MahleCube/solar-circuit/hardware/c07/matlab/README.md

必要環境：MATLAB、Simulink、Simscape、Simscape Electrical、Simscape Battery。
