MahleCube/solar-circuit/hardware/c07/pcb-wip/LICENSES/NOTICES.md

# Third-party asset notices

These notices accompany the symbol, footprint, and 3D-model assets in this C07 project. Each asset retains its upstream terms. This directory does not assign a new license to the circuit or PCB design as a whole.

## KiCad library data

KiCad library data, including KiCad-derived portions of the local symbol and footprint libraries, is provided under Creative Commons Attribution-ShareAlike 4.0 with the KiCad electronic-design exception. The exception and KiCad's redistribution guidance are reproduced unmodified in [KiCad-Libraries-License.md](KiCad-Libraries-License.md). The complete license text is in [CC-BY-SA-4.0.txt](CC-BY-SA-4.0.txt). Attribution is to the KiCad library contributors and the authors identified in individual files.

The following STEP files contain an explicit CC-BY-SA 4.0 notice and design exception in their original headers.

- `3dmodels/C07_Reviewed_Power.3dshapes/MSOP-16-1EP_3x4.039mm_P0.5mm_EP1.651x2.845mm.step`
- `3dmodels/C07_Reviewed_Power.3dshapes/MSOP-16_3x4.039mm_P0.5mm.step`
- `3dmodels/C07_Reviewed_Power.3dshapes/TO-263-2.step`
- `3dmodels/C07_Reviewed_Special.3dshapes/Nexperia_SOT363_3.step`
- `3dmodels/stock/Package_TO_SOT_SMD.3dshapes/TSOT-23-8.step`

The local KiCad-derived assets include project adaptations to geometry, pad dimensions, model associations, or package naming. Original attribution and license headers are retained.

## Legacy KiCad StepUp model

`3dmodels/C07_Reviewed_Special.3dshapes/Nexperia_SOD123F.step` retains its original `D_SOD-123F.step` header, copyright 2017 kicad StepUp, and GNU GPL version 3 or later with the embedded design-use exception. The full GPL version 3 text is in [GPL-3.0.txt](GPL-3.0.txt). The exact exception and risk disclaimer remain in the model header.

## Manufacturer and project models

Manufacturer-provided assets retain their embedded authorship information and applicable upstream terms. The Vishay notice is included at `3dmodels/manufacturer/99917_read_me_3D_disclaimer.pdf`. It describes the model as supplied as-is and does not provide a separate redistribution license.

Project-generated reference models and assembly envelopes are identified by their existing project records and file metadata. A manufacturer's name or part number in a filename identifies the represented part and does not by itself establish that the manufacturer supplied the model.

## Sources of the unmodified license documents

- CC-BY-SA 4.0 legal text — https://creativecommons.org/licenses/by-sa/4.0/legalcode.txt
- KiCad Libraries License and design exception — https://gitlab.com/kicad/libraries/kicad-symbols/-/raw/master/LICENSE.md
- KiCad library licensing guidance — https://www.kicad.org/libraries/license/
- GPL version 3 legal text — https://raw.githubusercontent.com/coreutils/coreutils/master/COPYING, as distributed by the GNU Coreutils project
- GPL version 3 canonical reference — https://www.gnu.org/licenses/gpl-3.0.html
