MahleCube/solar-circuit/hardware/c07/matlab/c07_preview.png

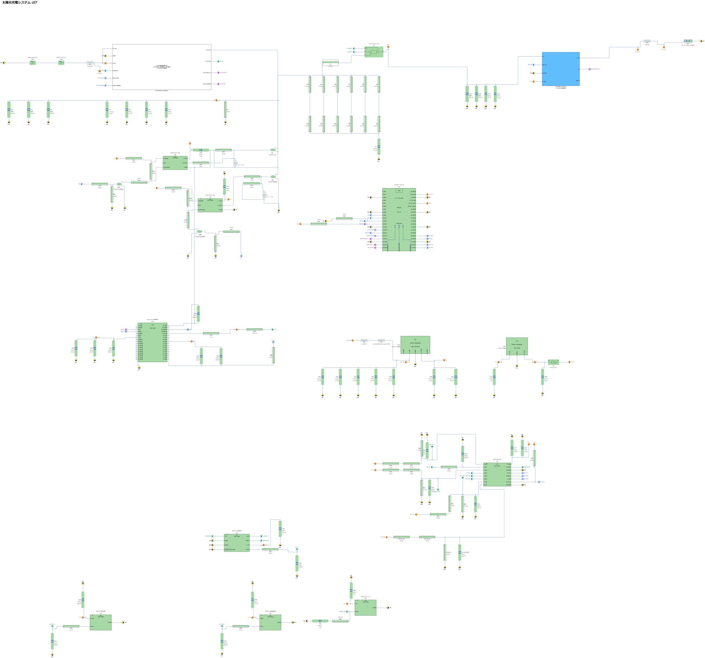
hardware/c07/matlab/c07_preview.png
