MahleCube/solar-circuit/docs/bom/c07_BOM.xlsx

Sheet: 部品集計
太陽光充電システム c07 BOM
1台分の図面BOM 2026-10-29作成 数量は購入パッケージ単位
総数量 | 188 | 集計行数 | 112 | 未選定 | 32 | 候補 | 6
パネル2枚・蓄電池1台を含む。Q3A・Q3BはデュアルMOSFET 1個として計上。
型番未選定・候補は状態欄で確認。基板、配線、端子台、ヒューズホルダー、放熱器、固定具は別途。
集計No | 部品種別 | メーカー型番 | 公称値・仕様 | 数量（個） | 部品番号 | 型番の状態 | 補足
BOM-001 | MOSFET | IPB048N15N5LFATMA1 | 150 V・4.8 mΩ（25℃・VGS=10 V） | 4 | PV_Q1, PV_Q2, P_Q1, P_Q2 | 候補含む | 図面で使用する候補。購入品としての確定・成立確認は未完了。
BOM-002 | MOSFET | PMGD175XNEX | デュアルNチャネル・30 V | 1 | Q3A / Q3B | 型番記載 | デュアルMOSFET。Q3A・Q3Bの2素子を購入数量1個として計上。
BOM-003 | MOSFET | TK9R6E15Q5,S1X | NチャネルMOSFET | 2 | Q1, Q2 | 型番記載
BOM-004 | IC | ACPL-P346-560E | フォトカプラ内蔵ゲートドライバ | 2 | U8, U9 | 型番記載
BOM-005 | IC | INA241A3IDDFR | 電流検出アンプ・50 V/V | 2 | U2, U3 | 型番記載
BOM-006 | IC | LTC4364IMS-1#PBF | LTC4364-1・MSOP-16 | 1 | P_U1 | 型番記載
BOM-007 | IC | LTC7000ARMSE#PBF | LTC7000A・高側ゲート駆動 | 1 | PV_U1 | 型番記載
BOM-008 | IC | MCP3208-CI/SL | 12 bit・8チャネル | 1 | U1 | 型番記載
BOM-009 | IC | REF3025EAIDBZR | REF3025EAIDBZR / 2.5V | 1 | U6 | 型番記載
BOM-010 | IC | SN74LVC1G11DBVR | 3入力ANDゲート | 1 | PV_U4 | 型番記載
BOM-011 | IC | SN74LVC1G74DCTR | Dフリップフロップ | 1 | PV_U5 | 型番記載
BOM-012 | IC | TLV3201AIDBVR | 高速コンパレータ | 1 | PV_U3 | 型番記載
BOM-013 | IC | TMP235A2DBZR | アナログ温度センサー | 2 | U4, U5 | 型番記載
BOM-014 | IC | TPS37042BJOFDDFRQ1 | 2系統電圧監視 | 1 | PV_U6 | 型番記載
BOM-015 | マイコンボード | SC0918 | Raspberry Pi Pico W (SC0918) | 1 | U7 | 型番記載
BOM-016 | 電源IC・モジュール | TSR 1-2450 | 12 V入力→5 V・1 A | 1 | U12 | 型番記載
BOM-017 | 電源IC・モジュール | TSR 1-48120WI | 電池入力→12 V・1 A | 1 | U11 | 型番記載
BOM-018 | 電源IC・モジュール | UCC14131QDWNRQ1 | 絶縁型・浮動約12 V出力 | 1 | U10 | 型番記載
BOM-019 | ダイオード | BZT52H-C15,115 | 15 V・ゲートクランプ | 3 | D1, D2, PV_D_GS | 型番記載
BOM-020 | ダイオード | CMZ5945B TR13 PBFREE | 68 V | 1 | P_D1 | 型番記載
BOM-021 | ダイオード | DDZ9702T | 15 V | 2 | P_D6, P_D7 | 型番記載
BOM-022 | ダイオード | MMBD1501A | 仕様は型番・図面説明を参照 | 1 | PV_D_BOOT | 型番候補 | 図面で使用する候補。購入品としての確定・成立確認は未完了。
BOM-023 | ダイオード | SS14-E3/61T | 40 V・1 A・ショットキー | 1 | D3 | 型番記載
BOM-024 | ダイオード | V20PW22-M3/I | 仕様は型番・図面説明を参照 | 3 | PV_D_FLY, PV_D_NEG, PV_D_TS | 型番候補 | 図面で使用する候補。購入品としての確定・成立確認は未完了。
BOM-025 | インダクタ | 74437636356203 | 62 µH | 1 | L2 | 型番記載
BOM-026 | インダクタ | NAC-20-0201 | 200 µH | 1 | L1 | 型番記載
BOM-027 | シャント抵抗 | CSS4J-4026R-1L00F | 1 mΩ・4端子 | 2 | R2, R27 | 型番記載
BOM-028 | シャント抵抗 | WSL36372L700FEA | 2.7 mΩ | 1 | P_RSNS | 型番記載
BOM-029 | 抵抗 | CRCW08051K00FKEA | 1 kΩ | 1 | P_RSHDN_SER | 型番記載
BOM-030 | 抵抗 | CRCW25124R42FKEGHP | 4.42 Ω | 12 | R3, R4, R5, R6, R7, R8, R9, R10, R11, R12, R13, R14 | 型番記載
BOM-031 | 抵抗 | CRCW25126K80FKEG | 6.8 kΩ | 1 | P_R4 | 型番記載
BOM-032 | 抵抗 | CRCW080510R0FKEA | 10 Ω | 1 | P_R5 | 型番記載
BOM-033 | 抵抗 | CRCW080522K0FKEA | 22 kΩ | 1 | P_RFLT_PU | 型番記載
BOM-034 | 抵抗 | CRCW080547K0FKEA | 47 kΩ | 1 | P_RSHDN_PD | 型番記載
BOM-035 | 抵抗 | ERJ3RSFR10V | 0.1 Ω 1% | 1 | R30 | 型番記載
BOM-036 | 抵抗 | ERJ6ENF10R0V | 10 Ω 1% 0.125W | 2 | R36, R43 | 型番記載
BOM-037 | 抵抗 | ERJ6ENF1002V | 10k 1% | 7 | R35, R37, R42, R44, R46, R48, R49 | 型番記載
BOM-038 | 抵抗 | ERJ6ENF1540V | 154 Ω 1% 0.125W | 2 | R32, R39 | 型番記載
BOM-039 | 抵抗 | ERJ6ENF2002V | 20k 1% | 2 | R33, R40 | 型番記載
BOM-040 | 抵抗 | ERJ6ENF2320V | 232 Ω 1% 0.125W | 2 | R31, R38 | 型番記載
BOM-041 | 抵抗 | ERJ6ENF3300V | 330 Ω 1% | 2 | R34, R41 | 型番記載
BOM-042 | 抵抗 | ERJ6ENF3832V | 38.3k 1% | 1 | R45 | 型番記載
BOM-043 | 抵抗 | ERJ6GEY0R00V | 0 Ω | 1 | R47 | 型番記載
BOM-044 | 抵抗 | PR02000201502FA100 | 15 kΩ | 1 | R1 | 型番記載
BOM-045 | 抵抗 | RC0603FR-0710KL | 10 kΩ | 1 | R15 | 型番記載
BOM-046 | 抵抗 | RG2012P-101-B-T5 | 100 Ω 0.1% | 2 | R25, R26 | 型番記載
BOM-047 | 抵抗 | RG2012P-332-B-T5 | 3.3 kΩ / 3.3 kΩ 0.1% | 4 | PV_RV_L, R18, R21, R24 | 型番記載
BOM-048 | 抵抗 | RG2012P-470-B-T5 | 47 Ω | 2 | R28, R29 | 型番記載
BOM-049 | 抵抗 | RG2012P-753-B-T5 | 75 kΩ / 75 kΩ 0.1% | 8 | PV_RV_H1, PV_RV_H2, R16, R17, R19, R20, R22, R23 | 型番記載
BOM-050 | 抵抗 | TNPW08052K74BEEA | 2.74 kΩ | 1 | P_R2 | 型番記載
BOM-051 | 抵抗 | TNPW08054K99BEEA | 4.99 kΩ | 2 | P_R3, P_R8 | 型番記載
BOM-052 | 抵抗 | TNPW0805236KBEEA | 236 kΩ | 1 | P_R7 | 型番記載
BOM-053 | 抵抗 | TNPW0805243KBEEA | 243 kΩ | 1 | P_R1 | 型番記載
BOM-054 | 抵抗 | 未選定 | 100 kΩ | 1 | PV_RAN | 型番未選定 | 公称値は図面の設定値。型番・定格・実装サイズは要選定。
BOM-055 | 抵抗 | 未選定 | 100 Ω | 1 | PV_RFLT | 型番未選定 | 公称値は図面の設定値。型番・定格・実装サイズは要選定。
BOM-056 | 抵抗 | 未選定 | 22 kΩ | 1 | PV_RFLT_PU | 型番未選定 | 公称値は図面の設定値。型番・定格・実装サイズは要選定。
BOM-057 | 抵抗 | 未選定 | 100 kΩ | 1 | PV_RG | 型番未選定 | 公称値は図面の設定値。型番・定格・実装サイズは要選定。
BOM-058 | 抵抗 | 未選定 | 10 MΩ | 1 | PV_RGS | 型番未選定 | 公称値は図面の設定値。型番・定格・実装サイズは要選定。
BOM-059 | 抵抗 | 未選定 | 100 kΩ | 1 | PV_RINP | 型番未選定 | 公称値は図面の設定値。型番・定格・実装サイズは要選定。
BOM-060 | 抵抗 | 未選定 | 820 kΩ | 1 | PV_ROV_H | 型番未選定 | 公称値は図面の設定値。型番・定格・実装サイズは要選定。
BOM-061 | 抵抗 | 未選定 | 10 kΩ | 1 | PV_ROV_L | 型番未選定 | 公称値は図面の設定値。型番・定格・実装サイズは要選定。
BOM-062 | 抵抗 | 未選定 | 100 kΩ | 1 | PV_RREARM | 型番未選定 | 公称値は図面の設定値。型番・定格・実装サイズは要選定。
BOM-063 | 抵抗 | 未選定 | 10.2 kΩ 0.1% | 1 | PV_RREV_H | 型番未選定 | 公称値は図面の設定値。型番・定格・実装サイズは要選定。
BOM-064 | 抵抗 | 未選定 | 9.8 kΩ 0.1% | 1 | PV_RREV_L | 型番未選定 | 公称値は図面の設定値。型番・定格・実装サイズは要選定。
BOM-065 | 抵抗 | 未選定 | 100 kΩ | 1 | PV_RRUN | 型番未選定 | 公称値は図面の設定値。型番・定格・実装サイズは要選定。
BOM-066 | 抵抗 | 未選定 | 100 kΩ | 1 | PV_RTIME | 型番未選定 | 公称値は図面の設定値。型番・定格・実装サイズは要選定。
BOM-067 | 抵抗 | 未選定 | 330 kΩ | 1 | PV_RUV_H | 型番未選定 | 公称値は図面の設定値。型番・定格・実装サイズは要選定。
BOM-068 | 抵抗 | 未選定 | 10.2 kΩ | 1 | PV_RUV_L | 型番未選定 | 公称値は図面の設定値。型番・定格・実装サイズは要選定。
BOM-069 | 抵抗 | 未選定 | 113 kΩ | 1 | PV_RVCCUV | 型番未選定 | 公称値は図面の設定値。型番・定格・実装サイズは要選定。
BOM-070 | 抵抗 | 未選定 | 10 Ω | 1 | PV_R_SLEW | 型番未選定 | 公称値は図面の設定値。型番・定格・実装サイズは要選定。
BOM-071 | 抵抗 | 未選定 | 21.3 kΩ | 1 | PV_R_SUP25 | 型番未選定 | 公称値は図面の設定値。型番・定格・実装サイズは要選定。
BOM-072 | 抵抗 | 未選定 | 10 kΩ | 1 | PV_R_SUP26 | 型番未選定 | 公称値は図面の設定値。型番・定格・実装サイズは要選定。
BOM-073 | 抵抗 | 未選定 | 31.2 kΩ | 1 | PV_R_SUP31 | 型番未選定 | 公称値は図面の設定値。型番・定格・実装サイズは要選定。
BOM-074 | 抵抗 | 未選定 | 10 kΩ | 1 | PV_R_SUP32 | 型番未選定 | 公称値は図面の設定値。型番・定格・実装サイズは要選定。
BOM-075 | 抵抗 | 未選定 | 10 kΩ | 1 | PV_R_SUP_PU | 型番未選定 | 公称値は図面の設定値。型番・定格・実装サイズは要選定。
BOM-076 | 積層セラミックC | AC0603JPNPO9BN681 | 680 pF | 2 | C27, C29 | 型番記載
BOM-077 | 積層セラミックC | C0805C104K4RACTU | 100 nF | 1 | C17 | 型番記載
BOM-078 | 積層セラミックC | C0805C331J5GACTU | 330pF 50V C0G 5% | 1 | C39 | 型番記載
BOM-079 | 積層セラミックC | C1210X225K1RACAUTO | 2.2µF 100V X7R | 5 | C40, C41, C42, C43, C44 | 型番記載
BOM-080 | 積層セラミックC | C1608X7R1H104K080AA | 100nF 50V | 2 | C22, C24 | 型番記載
BOM-081 | 積層セラミックC | C2012X7R1H105K125AB | 1 µF | 2 | C30, C31 | 型番記載
BOM-082 | 積層セラミックC | C3225C0G2J223J230AA | 22 nF | 1 | C1 | 型番記載
BOM-083 | 積層セラミックC | C3225X7R2A225K230AB | 2.2 µF | 1 | C18 | 型番記載
BOM-084 | 積層セラミックC | C5750X7T2E225K250KE | 2.2 µF | 3 | C8, C9, C10 | 型番記載
BOM-085 | 積層セラミックC | CC0603KRX7R9BB104 | 100 nF | 8 | C19, C20, C21, C23, C25, C26, C28, PV_CV_ADC | 型番記載
BOM-086 | 積層セラミックC | GRM21BR71H104KA01L | 100nF 50V X7R | 2 | C36, C38 | 型番記載
BOM-087 | 積層セラミックC | GRM21BR71H105KA12L | 1µF 50V X7R | 3 | C32, C33, C47 | 型番記載
BOM-088 | 積層セラミックC | GRM32EC72A106KE05L | 10 µF | 2 | C15, C16 | 型番記載
BOM-089 | 積層セラミックC | GRM32ER71E226KE15L | 22µF 25V X7R | 5 | C34, C35, C37, C45, C48 | 型番記載
BOM-090 | 電解コンデンサ | 100ZLH470MEFC16X31.5 | 470 µF | 2 | C13, C14 | 型番記載
BOM-091 | 電解コンデンサ | EEHZK1E471P | 470µF 25V hybrid | 1 | C46 | 型番記載
BOM-092 | 電解コンデンサ | UCY2C471MHD | 470 µF | 3 | C2, C3, C4 | 型番記載
BOM-093 | フィルムコンデンサ | R76IR433050H3J | 3.3 µF | 1 | C7 | 型番記載
BOM-094 | コンデンサ | 100ZLH330MEFC12.5X35 | 330 µF | 1 | P_COUT | 型番記載
BOM-095 | コンデンサ | CGA5L2C0G1H104J160AE | 100 nF | 1 | P_CTMR | 型番記載
BOM-096 | コンデンサ | CGA6P3C0G2E473J250AA | 47 nF | 1 | P_CHG | 型番記載
BOM-097 | コンデンサ | 未選定 | 10 µF | 1 | PV_CBST | 型番未選定 | 公称値は図面の設定値。型番・定格・実装サイズは要選定。 25 V級は図面説明上の候補。
BOM-098 | コンデンサ | 未選定 | 10 nF / 16 V | 1 | PV_CREV | 型番未選定 | 公称値は図面の設定値。型番・定格・実装サイズは要選定。
BOM-099 | コンデンサ | 未選定 | 1 nF / 25 V | 1 | PV_CTIME | 型番未選定 | 公称値は図面の設定値。型番・定格・実装サイズは要選定。
BOM-100 | コンデンサ | 未選定 | 1 µF / 25 V | 1 | PV_CVCC | 型番未選定 | 公称値は図面の設定値。型番・定格・実装サイズは要選定。
BOM-101 | コンデンサ | 未選定 | 100 nF / 200 V | 1 | PV_CVIN | 型番未選定 | 公称値は図面の設定値。型番・定格・実装サイズは要選定。
BOM-102 | コンデンサ | 未選定 | 100 nF / 16 V | 1 | PV_C_PV_U3 | 型番未選定 | 公称値は図面の設定値。型番・定格・実装サイズは要選定。
BOM-103 | コンデンサ | 未選定 | 100 nF / 16 V | 1 | PV_C_PV_U4 | 型番未選定 | 公称値は図面の設定値。型番・定格・実装サイズは要選定。
BOM-104 | コンデンサ | 未選定 | 100 nF / 16 V | 1 | PV_C_PV_U5 | 型番未選定 | 公称値は図面の設定値。型番・定格・実装サイズは要選定。
BOM-105 | コンデンサ | 未選定 | 100 nF | 1 | PV_C_SLEW | 型番未選定 | 公称値は図面の設定値。型番・定格・実装サイズは要選定。
BOM-106 | コンデンサ | 未選定 | 100 nF | 1 | PV_C_SUP | 型番未選定 | 公称値は図面の設定値。型番・定格・実装サイズは要選定。
BOM-107 | ヒューズ | 0001.2706.11 | 1.6A 300VDC time-lag T SMD | 1 | F1 | 型番記載
BOM-108 | ヒューズ | HP10M20 | 20A gPV | 1 | F2 | 型番記載
BOM-109 | ヒューズ | LP-CC-3-2/10 | 3.2A DC | 1 | F4 | 型番記載
BOM-110 | ヒューズ | LP-CC-25 | 25A DC | 1 | F3 | 型番記載
BOM-111 | 太陽電池モジュール | AXITEC AC-400MH/108V | 400 W・2枚直列のうち1枚 | 2 | PV1, PV2 | 型番記載
BOM-112 | 蓄電池パック | LiTime 51.2V 100Ah | 51.2V 100Ah LiFePO4 | 1 | BT1 | 型番記載

Sheet: 部品明細
部品番号別の明細
出典：solar_pv_protected_c07_circuit.slx の保存部品説明・設定値
回路区分で絞り込み可能。数量を変更すると「部品集計」が再計算されます。
参照版 SHA-256：93a86777bbce3dad3e9d25e4e59a425bd6d9b57553a643c98db22428fe50a800
仕様・型番は保存図面の記載。新たな部品選定・価格調査は行っていません。
集計No | 回路区分 | 部品番号 | 部品種別 | メーカー型番 | 公称値・仕様 | 数量（個） | 用途 | 型番の状態 | 補足 | 参照ブロック
BOM-082 | 主電力段 | C1 | 積層セラミックC | C3225C0G2J223J230AA | 22 nF | 1 | 主電力段のスイッチが切り替わった後に起こる、電圧の振動を抑えるためのコンデンサ。 | 型番記載 |  | C1
BOM-092 | 主電力段 | C2 | 電解コンデンサ | UCY2C471MHD | 470 µF | 1 | 太陽光パネルから給電される主電力段の入力側に電荷を蓄え、入力電圧の落ち込みや変動を抑えるためのコンデンサ。 | 型番記載 |  | C2
BOM-092 | 主電力段 | C3 | 電解コンデンサ | UCY2C471MHD | 470 µF | 1 | 太陽光パネルから給電される主電力段の入力側に電荷を蓄え、入力電圧の落ち込みや変動を抑えるためのコンデンサ。 | 型番記載 |  | C3
BOM-092 | 主電力段 | C4 | 電解コンデンサ | UCY2C471MHD | 470 µF | 1 | 太陽光パネルから給電される主電力段の入力側に電荷を蓄え、入力電圧の落ち込みや変動を抑えるためのコンデンサ。 | 型番記載 |  | C4
BOM-093 | 主電力段 | C7 | フィルムコンデンサ | R76IR433050H3J | 3.3 µF | 1 | 主電力段の切替えに伴う短い電流を近くで受け持ち、入力側の大容量コンデンサを補うためのフィルムコンデンサ。 | 型番記載 |  | C7
BOM-084 | 主電力段 | C8 | 積層セラミックC | C5750X7T2E225K250KE | 2.2 µF | 1 | 主電力段のすぐ近くで速い電流変化を受け止め、遠い電源配線へ流れ出す高周波成分を減らすためのコンデンサ。 | 型番記載 |  | C8
BOM-084 | 主電力段 | C9 | 積層セラミックC | C5750X7T2E225K250KE | 2.2 µF | 1 | 主電力段のすぐ近くで速い電流変化を受け止め、遠い電源配線へ流れ出す高周波成分を減らすためのコンデンサ。 | 型番記載 |  | C9
BOM-084 | 主電力段 | C10 | 積層セラミックC | C5750X7T2E225K250KE | 2.2 µF | 1 | 主電力段のすぐ近くで速い電流変化を受け止め、遠い電源配線へ流れ出す高周波成分を減らすためのコンデンサ。 | 型番記載 |  | C10
BOM-090 | 主電力段 | C13 | 電解コンデンサ | 100ZLH470MEFC16X31.5 | 470 µF | 1 | インダクタL1から入る電流とバッテリーへ送る電流の差を、電荷の出し入れで一時的に受け持ち、降圧回路の出力電圧をならすためのコンデンサ。 | 型番記載 |  | C13
BOM-090 | 主電力段 | C14 | 電解コンデンサ | 100ZLH470MEFC16X31.5 | 470 µF | 1 | インダクタL1から入る電流とバッテリーへ送る電流の差を、電荷の出し入れで一時的に受け持ち、降圧回路の出力電圧をならすためのコンデンサ。 | 型番記載 |  | C14
BOM-088 | 主電力段 | C15 | 積層セラミックC | GRM32EC72A106KE05L | 10 µF | 1 | 降圧回路の出力側で速い電圧・電流の変化を受け止め、大容量の出力コンデンサを補うためのコンデンサ。 | 型番記載 |  | C15
BOM-088 | 主電力段 | C16 | 積層セラミックC | GRM32EC72A106KE05L | 10 µF | 1 | 降圧回路の出力側で速い電圧・電流の変化を受け止め、大容量の出力コンデンサを補うためのコンデンサ。 | 型番記載 |  | C16
BOM-108 | 主電力段 | F2 | ヒューズ | HP10M20 | 20A gPV | 1 | 太陽電池から充電器へ向かう入力配線を、過電流から保護するためのヒューズ。 | 型番記載 |  | F2
BOM-110 | 主電力段 | F3 | ヒューズ | LP-CC-25 | 25A DC | 1 | 電池と充電器を結ぶ主充電経路を、過電流から保護するためのヒューズ。 | 型番記載 |  | F3
BOM-026 | 主電力段 | L1 | インダクタ | NAC-20-0201 | 200 µH | 1 | 太陽電池から電池へ電力を送るとき、充電電流をならすための主インダクタ。 | 型番記載 |  | L1
BOM-003 | 主電力段 | Q1 | MOSFET | TK9R6E15Q5,S1X | NチャネルMOSFET | 1 | 太陽電池から主インダクタL1へ電力を送り込む、降圧回路の上側スイッチ。 | 型番記載 |  | Q1
BOM-003 | 主電力段 | Q2 | MOSFET | TK9R6E15Q5,S1X | NチャネルMOSFET | 1 | 上側スイッチQ1がOFFの間にも、L1の電流が流れ続ける経路を作る下側スイッチ。 | 型番記載 |  | Q2
BOM-044 | 主電力段 | R1 | 抵抗 | PR02000201502FA100 | 15 kΩ | 1 | 充電器の入力コンデンサに残った電荷を、電源を切った後に少しずつ抜くための抵抗。 | 型番記載 |  | R1
BOM-030 | 主電力段 | R3 | 抵抗 | CRCW25124R42FKEGHP | 4.42 Ω | 1 | 主電力MOSFET Q1・Q2の切替え時に生じる、電圧の振動を弱めるためのスナバ抵抗。 | 型番記載 |  | R3
BOM-030 | 主電力段 | R4 | 抵抗 | CRCW25124R42FKEGHP | 4.42 Ω | 1 | 主電力MOSFET Q1・Q2の切替え時に生じる、電圧の振動を弱めるためのスナバ抵抗。 | 型番記載 |  | R4
BOM-030 | 主電力段 | R5 | 抵抗 | CRCW25124R42FKEGHP | 4.42 Ω | 1 | 主電力MOSFET Q1・Q2の切替え時に生じる、電圧の振動を弱めるためのスナバ抵抗。 | 型番記載 |  | R5
BOM-030 | 主電力段 | R6 | 抵抗 | CRCW25124R42FKEGHP | 4.42 Ω | 1 | 主電力MOSFET Q1・Q2の切替え時に生じる、電圧の振動を弱めるためのスナバ抵抗。 | 型番記載 |  | R6
BOM-030 | 主電力段 | R7 | 抵抗 | CRCW25124R42FKEGHP | 4.42 Ω | 1 | 主電力MOSFET Q1・Q2の切替え時に生じる、電圧の振動を弱めるためのスナバ抵抗。 | 型番記載 |  | R7
BOM-030 | 主電力段 | R8 | 抵抗 | CRCW25124R42FKEGHP | 4.42 Ω | 1 | 主電力MOSFET Q1・Q2の切替え時に生じる、電圧の振動を弱めるためのスナバ抵抗。 | 型番記載 |  | R8
BOM-030 | 主電力段 | R9 | 抵抗 | CRCW25124R42FKEGHP | 4.42 Ω | 1 | 主電力MOSFET Q1・Q2の切替え時に生じる、電圧の振動を弱めるためのスナバ抵抗。 | 型番記載 |  | R9
BOM-030 | 主電力段 | R10 | 抵抗 | CRCW25124R42FKEGHP | 4.42 Ω | 1 | 主電力MOSFET Q1・Q2の切替え時に生じる、電圧の振動を弱めるためのスナバ抵抗。 | 型番記載 |  | R10
BOM-030 | 主電力段 | R11 | 抵抗 | CRCW25124R42FKEGHP | 4.42 Ω | 1 | 主電力MOSFET Q1・Q2の切替え時に生じる、電圧の振動を弱めるためのスナバ抵抗。 | 型番記載 |  | R11
BOM-030 | 主電力段 | R12 | 抵抗 | CRCW25124R42FKEGHP | 4.42 Ω | 1 | 主電力MOSFET Q1・Q2の切替え時に生じる、電圧の振動を弱めるためのスナバ抵抗。 | 型番記載 |  | R12
BOM-030 | 主電力段 | R13 | 抵抗 | CRCW25124R42FKEGHP | 4.42 Ω | 1 | 主電力MOSFET Q1・Q2の切替え時に生じる、電圧の振動を弱めるためのスナバ抵抗。 | 型番記載 |  | R13
BOM-030 | 主電力段 | R14 | 抵抗 | CRCW25124R42FKEGHP | 4.42 Ω | 1 | 主電力MOSFET Q1・Q2の切替え時に生じる、電圧の振動を弱めるためのスナバ抵抗。 | 型番記載 |  | R14
BOM-087 | ゲート駆動 | C32 | 積層セラミックC | GRM21BR71H105KA12L | 1µF 50V X7R | 1 | 上側ゲートドライバU8がQ1をオンにする瞬間に、ゲートへ送る電荷を近くで供給するためのコンデンサ。 | 型番記載 |  | C32
BOM-087 | ゲート駆動 | C33 | 積層セラミックC | GRM21BR71H105KA12L | 1µF 50V X7R | 1 | 下側ゲートドライバU9がQ2をオンにする瞬間に、ゲートへ送る電荷を近くで供給するためのコンデンサ。 | 型番記載 |  | C33
BOM-019 | ゲート駆動 | D1 | ダイオード | BZT52H-C15,115 | 15 V・ゲートクランプ | 1 | 上側MOSFET Q1のゲートに過大な電圧がかかるのを抑える保護用ダイオード。 | 型番記載 |  | D1
BOM-019 | ゲート駆動 | D2 | ダイオード | BZT52H-C15,115 | 15 V・ゲートクランプ | 1 | 下側MOSFET Q2のゲートに過大な電圧がかかるのを抑える保護用ダイオード。 | 型番記載 |  | D2
BOM-002 | ゲート駆動 | Q3A / Q3B | MOSFET | PMGD175XNEX | dual 30V logic-level LED sink | 1 | 上下ゲートドライバのLEDを駆動する2素子を、1パッケージで使用。 | 型番記載 | デュアルMOSFET。Q3A・Q3Bの2素子を購入数量1個として計上。 | Q3A ; Q3B
BOM-040 | ゲート駆動 | R31 | 抵抗 | ERJ6ENF2320V | 232 Ω 1% 0.125W | 1 | 上側ゲートドライバU8へ制御信号を伝える発光素子に、流れすぎる電流を抑えるための抵抗。 | 型番記載 |  | R31
BOM-038 | ゲート駆動 | R32 | 抵抗 | ERJ6ENF1540V | 154 Ω 1% 0.125W | 1 | 上側ゲートドライバU8の発光素子に流す電流を、R31と一緒に制限するための抵抗。 | 型番記載 |  | R32
BOM-039 | ゲート駆動 | R33 | 抵抗 | ERJ6ENF2002V | 20k 1% | 1 | 上側ゲートドライバU8の発光素子が、わずかな漏れ電流で意図せず光ることを抑えるための抵抗。 | 型番記載 |  | R33
BOM-041 | ゲート駆動 | R34 | 抵抗 | ERJ6ENF3300V | 330 Ω 1% | 1 | 上側ゲートドライバへ信号を送る小型MOSFET Q3Aを、マイコンから駆動するときの瞬間電流を抑えるための抵抗。 | 型番記載 |  | R34
BOM-037 | ゲート駆動 | R35 | 抵抗 | ERJ6ENF1002V | 10k 1% | 1 | マイコンが信号を出していないとき、上側ゲートドライバU8へ送る光信号を消灯側に置くための抵抗。 | 型番記載 |  | R35
BOM-036 | ゲート駆動 | R36 | 抵抗 | ERJ6ENF10R0V | 10 Ω 1% 0.125W | 1 | 上側の主電力MOSFET Q1をオン・オフする速さを調整するための抵抗。 | 型番記載 |  | R36
BOM-037 | ゲート駆動 | R37 | 抵抗 | ERJ6ENF1002V | 10k 1% | 1 | 上側の主電力MOSFET Q1を、ゲートドライバが動いていないときにオフ側へ戻すための抵抗。 | 型番記載 |  | R37
BOM-040 | ゲート駆動 | R38 | 抵抗 | ERJ6ENF2320V | 232 Ω 1% 0.125W | 1 | 下側ゲートドライバU9へ制御信号を伝える発光素子に、流れすぎる電流を抑えるための抵抗。 | 型番記載 |  | R38
BOM-038 | ゲート駆動 | R39 | 抵抗 | ERJ6ENF1540V | 154 Ω 1% 0.125W | 1 | 下側ゲートドライバU9の発光素子に流す電流を、R38と一緒に制限するための抵抗。 | 型番記載 |  | R39
BOM-039 | ゲート駆動 | R40 | 抵抗 | ERJ6ENF2002V | 20k 1% | 1 | 下側ゲートドライバU9の発光素子が、わずかな漏れ電流で意図せず光ることを抑えるための抵抗。 | 型番記載 |  | R40
BOM-041 | ゲート駆動 | R41 | 抵抗 | ERJ6ENF3300V | 330 Ω 1% | 1 | 下側ゲートドライバへ信号を送る小型MOSFET Q3Bを、マイコンから駆動するときの瞬間電流を抑えるための抵抗。 | 型番記載 |  | R41
BOM-037 | ゲート駆動 | R42 | 抵抗 | ERJ6ENF1002V | 10k 1% | 1 | マイコンが信号を出していないとき、下側ゲートドライバU9へ送る光信号を消灯側に置くための抵抗。 | 型番記載 |  | R42
BOM-036 | ゲート駆動 | R43 | 抵抗 | ERJ6ENF10R0V | 10 Ω 1% 0.125W | 1 | 下側の主電力MOSFET Q2をオン・オフする速さを調整するための抵抗。 | 型番記載 |  | R43
BOM-037 | ゲート駆動 | R44 | 抵抗 | ERJ6ENF1002V | 10k 1% | 1 | 下側の主電力MOSFET Q2を、ゲートドライバが動いていないときにオフ側へ戻すための抵抗。 | 型番記載 |  | R44
BOM-004 | ゲート駆動 | U8 | IC | ACPL-P346-560E | フォトカプラ内蔵ゲートドライバ | 1 | マイコン側の指令を、上側MOSFET Q1をON/OFFできるゲート駆動へ変える部品。 | 型番記載 |  | U8
BOM-004 | ゲート駆動 | U9 | IC | ACPL-P346-560E | フォトカプラ内蔵ゲートドライバ | 1 | マイコン側の指令を、下側MOSFET Q2をON/OFFできるゲート駆動へ変える部品。 | 型番記載 |  | U9
BOM-089 | 補助電源 | C34 | 積層セラミックC | GRM32ER71E226KE15L | 22µF 25V X7R | 1 | 上側ゲート駆動用の絶縁電源U10へ入る12 Vを支え、入力電流の変化を近くで受け止めるためのコンデンサ。 | 型番記載 |  | C34
BOM-089 | 補助電源 | C35 | 積層セラミックC | GRM32ER71E226KE15L | 22µF 25V X7R | 1 | 上側ゲート駆動用の絶縁電源U10へ入る12 Vを支え、入力電流の変化を近くで受け止めるためのコンデンサ。 | 型番記載 |  | C35
BOM-086 | 補助電源 | C36 | 積層セラミックC | GRM21BR71H104KA01L | 100nF 50V X7R | 1 | 絶縁電源U10の入力側で、内部の速いスイッチングに伴う電流を近くで受け止めるためのコンデンサ。 | 型番記載 |  | C36
BOM-089 | 補助電源 | C37 | 積層セラミックC | GRM32ER71E226KE15L | 22µF 25V X7R | 1 | 絶縁電源U10が作る上側ゲート駆動用の約12 Vを支え、U8へ渡す電荷を蓄えるためのコンデンサ。 | 型番記載 |  | C37
BOM-086 | 補助電源 | C38 | 積層セラミックC | GRM21BR71H104KA01L | 100nF 50V X7R | 1 | 絶縁電源U10の出力側で、内部の速いスイッチングに伴う電流を近くで受け止めるためのコンデンサ。 | 型番記載 |  | C38
BOM-078 | 補助電源 | C39 | 積層セラミックC | C0805C331J5GACTU | 330pF 50V C0G 5% | 1 | 絶縁電源U10が自分の出力電圧を読み取る信号から、速い揺れを減らすためのコンデンサ。 | 型番記載 |  | C39
BOM-079 | 補助電源 | C40 | 積層セラミックC | C1210X225K1RACAUTO | 2.2µF 100V X7R | 1 | バッテリーから12 Vを作る補助電源U11の入力を支え、電流の脈動を近くで受け止めるためのコンデンサ。 | 型番記載 |  | C40
BOM-079 | 補助電源 | C41 | 積層セラミックC | C1210X225K1RACAUTO | 2.2µF 100V X7R | 1 | バッテリーから12 Vを作る補助電源U11の入力を支え、電流の脈動を近くで受け止めるためのコンデンサ。 | 型番記載 |  | C41
BOM-079 | 補助電源 | C42 | 積層セラミックC | C1210X225K1RACAUTO | 2.2µF 100V X7R | 1 | バッテリーから12 Vを作る補助電源U11の入力を支え、電流の脈動を近くで受け止めるためのコンデンサ。 | 型番記載 |  | C42
BOM-079 | 補助電源 | C43 | 積層セラミックC | C1210X225K1RACAUTO | 2.2µF 100V X7R | 1 | バッテリーから12 Vを作る補助電源U11の入力を支え、電流の脈動を近くで受け止めるためのコンデンサ。 | 型番記載 |  | C43
BOM-079 | 補助電源 | C44 | 積層セラミックC | C1210X225K1RACAUTO | 2.2µF 100V X7R | 1 | バッテリーから12 Vを作る補助電源U11の入力を支え、電流の脈動を近くで受け止めるためのコンデンサ。 | 型番記載 |  | C44
BOM-089 | 補助電源 | C45 | 積層セラミックC | GRM32ER71E226KE15L | 22µF 25V X7R | 1 | 補助電源U11が作る12 Vの細かな変動を抑え、下流へ給電しやすくするためのコンデンサ。 | 型番記載 |  | C45
BOM-091 | 補助電源 | C46 | 電解コンデンサ | EEHZK1E471P | 470µF 25V hybrid | 1 | 共通12 V電源に電荷を多めに蓄え、接続された回路の消費電流が増えたときに補うためのコンデンサ。 | 型番記載 |  | C46
BOM-087 | 補助電源 | C47 | 積層セラミックC | GRM21BR71H105KA12L | 1µF 50V X7R | 1 | 12 Vから5 Vを作る補助電源U12の入力を支え、電流の脈動を近くで受け止めるためのコンデンサ。 | 型番記載 |  | C47
BOM-089 | 補助電源 | C48 | 積層セラミックC | GRM32ER71E226KE15L | 22µF 25V X7R | 1 | マイコン基板などへ渡す5 V電源に電荷を蓄え、消費電流の変化を支えるためのコンデンサ。 | 型番記載 |  | C48
BOM-023 | 補助電源 | D3 | ダイオード | SS14-E3/61T | 40 V・1 A・ショットキー | 1 | マイコン基板U7へ5 Vを渡し、基板側から補助5 V電源へ電流が戻るのを抑えるダイオード。 | 型番記載 |  | D3
BOM-107 | 補助電源 | F1 | ヒューズ | 0001.2706.11 | 1.6A 300VDC time-lag T SMD | 1 | 12 V電源モジュールU11へ向かう補助電源入力の過電流に対処するヒューズ。 | 型番記載 |  | F1
BOM-109 | 補助電源 | F4 | ヒューズ | LP-CC-3-2/10 | 3.2A DC | 1 | 電池から補助電源へ分岐する配線を、過電流から保護するためのヒューズ。 | 型番記載 |  | F4
BOM-042 | 補助電源 | R45 | 抵抗 | ERJ6ENF3832V | 38.3k 1% | 1 | 上側ゲートドライバU8用の電源を、約12 Vに設定するための抵抗。 | 型番記載 |  | R45
BOM-037 | 補助電源 | R46 | 抵抗 | ERJ6ENF1002V | 10k 1% | 1 | 上側ゲートドライバU8用の電源電圧を、R45と一緒に決めるための抵抗。 | 型番記載 |  | R46
BOM-043 | 補助電源 | R47 | 抵抗 | ERJ6GEY0R00V | 0 Ω | 1 | 上側ゲート駆動用電源U10の、出力調整回路の設定接続を作るための0 Ω抵抗。 | 型番記載 |  | R47
BOM-037 | 補助電源 | R48 | 抵抗 | ERJ6ENF1002V | 10k 1% | 1 | マイコンが指令を出していないとき、上側ゲート駆動用の絶縁電源U10を停止側に置くための抵抗。 | 型番記載 |  | R48
BOM-037 | 補助電源 | R49 | 抵抗 | ERJ6ENF1002V | 10k 1% | 1 | 絶縁電源U10から返る状態通知を、マイコンU7のGP9がHigh・Lowとして読めるようにするための抵抗。 | 型番記載 |  | R49
BOM-018 | 補助電源 | U10 | 電源IC・モジュール | UCC14131QDWNRQ1 | 絶縁型・浮動約12 V出力 | 1 | 上側ゲートドライバU8用の約12 V電源を作る部品。入力と出力を電気的に絶縁するトランスを内蔵した電源モジュール。 | 型番記載 |  | U10
BOM-017 | 補助電源 | U11 | 電源IC・モジュール | TSR 1-48120WI | 電池入力→12 V・1 A | 1 | ゲート駆動回路や、ほかの補助電源に使う12 Vを電池から作る電源モジュール。 | 型番記載 |  | U11
BOM-016 | 補助電源 | U12 | 電源IC・モジュール | TSR 1-2450 | 12 V入力→5 V・1 A | 1 | マイコン基板とゲートドライバの入力側に使う5 Vを作る電源モジュール。 | 型番記載 |  | U12
BOM-077 | 測定・制御 | C17 | 積層セラミックC | C0805C104K4RACTU | 100 nF | 1 | 測定電圧を数値に変換するU1の3.3 V電源を、瞬間的な変動から支えるためのコンデンサ。 | 型番記載 |  | C17
BOM-083 | 測定・制御 | C18 | 積層セラミックC | C3225X7R2A225K230AB | 2.2 µF | 1 | 3.3 Vで動く計測回路の近くに電荷を蓄え、計測回路全体の消費電流の変化を支えるためのコンデンサ。 | 型番記載 |  | C18
BOM-085 | 測定・制御 | C19 | 積層セラミックC | CC0603KRX7R9BB104 | 100 nF | 1 | 太陽光パネル側の入力電圧を測る信号の速い揺れを抑え、U1が読み取りやすくするためのコンデンサ。 | 型番記載 |  | C19
BOM-085 | 測定・制御 | C20 | 積層セラミックC | CC0603KRX7R9BB104 | 100 nF | 1 | 保護回路に入る前の出力電圧を測る信号の速い揺れを抑え、U1が読み取りやすくするためのコンデンサ。 | 型番記載 |  | C20
BOM-085 | 測定・制御 | C21 | 積層セラミックC | CC0603KRX7R9BB104 | 100 nF | 1 | バッテリー電圧を測る信号の速い揺れを抑え、U1が読み取りやすくするためのコンデンサ。 | 型番記載 |  | C21
BOM-080 | 測定・制御 | C22 | 積層セラミックC | C1608X7R1H104K080AA | 100nF 50V | 1 | パネル電流を測るU2の3.3 V電源を、瞬間的な変動から支えるためのコンデンサ。 | 型番記載 |  | PV_Reverse_Protection/C22
BOM-085 | 測定・制御 | C23 | 積層セラミックC | CC0603KRX7R9BB104 | 100 nF | 1 | パネル電流の測定信号から速い電気的な揺れを減らし、U1が読み取りやすくするためのコンデンサ。 | 型番記載 |  | C23
BOM-080 | 測定・制御 | C24 | 積層セラミックC | C1608X7R1H104K080AA | 100nF 50V | 1 | インダクタL1を通った出力電流を測るU3の3.3 V電源を、瞬間的な変動から支えるためのコンデンサ。 | 型番記載 |  | C24
BOM-085 | 測定・制御 | C25 | 積層セラミックC | CC0603KRX7R9BB104 | 100 nF | 1 | インダクタL1を通る出力電流の測定信号から速い電気的な揺れを減らし、U1が読み取りやすくするためのコンデンサ。 | 型番記載 |  | C25
BOM-085 | 測定・制御 | C26 | 積層セラミックC | CC0603KRX7R9BB104 | 100 nF | 1 | バッテリー側の温度センサーU4の3.3 V電源を、瞬間的な変動から支えるためのコンデンサ。 | 型番記載 |  | C26
BOM-076 | 測定・制御 | C27 | 積層セラミックC | AC0603JPNPO9BN681 | 680 pF | 1 | バッテリーの温度信号に重なる速い電気的な乱れを、読み取り回路の入口で弱めるための小容量コンデンサ。 | 型番記載 |  | C27
BOM-085 | 測定・制御 | C28 | 積層セラミックC | CC0603KRX7R9BB104 | 100 nF | 1 | 放熱器側の温度センサーU5の3.3 V電源を、瞬間的な変動から支えるためのコンデンサ。 | 型番記載 |  | C28
BOM-076 | 測定・制御 | C29 | 積層セラミックC | AC0603JPNPO9BN681 | 680 pF | 1 | 放熱器の温度信号に重なる速い電気的な乱れを、読み取り回路の入口で弱めるための小容量コンデンサ。 | 型番記載 |  | C29
BOM-081 | 測定・制御 | C30 | 積層セラミックC | C2012X7R1H105K125AB | 1 µF | 1 | 計測の基準となる2.5 Vを作るU6へ、安定した入力電源を渡すためのコンデンサ。 | 型番記載 |  | C30
BOM-081 | 測定・制御 | C31 | 積層セラミックC | C2012X7R1H105K125AB | 1 µF | 1 | 計測の物差しとなる2.5 V基準電圧を支え、読み取り時に必要な電荷を近くで補うためのコンデンサ。 | 型番記載 |  | C31
BOM-085 | 測定・制御 | PV_CV_ADC | コンデンサ | CC0603KRX7R9BB104 | 100 nF | 1 | 上流パネル電圧のADC入力を落ち着かせる局所コンデンサ。 | 型番記載 |  | PV_CV_ADC
BOM-049 | 測定・制御 | PV_RV_H1 | 抵抗 | RG2012P-753-B-T5 | 75 kΩ | 1 | 上流パネル電圧をADCへ渡す分圧器の上側1本目。 | 型番記載 |  | PV_RV_H1
BOM-049 | 測定・制御 | PV_RV_H2 | 抵抗 | RG2012P-753-B-T5 | 75 kΩ | 1 | 上流パネル電圧をADCへ渡す分圧器の上側2本目。 | 型番記載 |  | PV_RV_H2
BOM-047 | 測定・制御 | PV_RV_L | 抵抗 | RG2012P-332-B-T5 | 3.3 kΩ | 1 | 上流パネル電圧をADCで読める電圧へ下げる分圧器の下側抵抗。 | 型番記載 |  | PV_RV_L
BOM-027 | 測定・制御 | R2 | シャント抵抗 | CSS4J-4026R-1L00F | 1 mΩ・4端子 | 1 | インダクタを出た充電電流を測るための、小さな抵抗。 | 型番記載 |  | R2
BOM-045 | 測定・制御 | R15 | 抵抗 | RC0603FR-0710KL | 10 kΩ | 1 | マイコンがまだ信号を出していない間、測定用の変換IC U1を通信の非選択状態に置くための抵抗。 | 型番記載 |  | R15
BOM-049 | 測定・制御 | R16 | 抵抗 | RG2012P-753-B-T5 | 75 kΩ 0.1% | 1 | 太陽光パネル側の入力電圧を、測定用の変換IC U1に入力できる小さな電圧へ縮めるための抵抗。 | 型番記載 |  | R16
BOM-049 | 測定・制御 | R17 | 抵抗 | RG2012P-753-B-T5 | 75 kΩ 0.1% | 1 | 太陽光パネル側の入力電圧の測定で、電圧を小さくする働きと抵抗一個あたりの電圧負担を、R16と分けるための抵抗。 | 型番記載 |  | R17
BOM-047 | 測定・制御 | R18 | 抵抗 | RG2012P-332-B-T5 | 3.3 kΩ 0.1% | 1 | 太陽光パネル側の入力電圧を何分の一にして測定するかを、上側の抵抗と一緒に決めるための抵抗。 | 型番記載 |  | R18
BOM-049 | 測定・制御 | R19 | 抵抗 | RG2012P-753-B-T5 | 75 kΩ 0.1% | 1 | 充電器の出力電圧を、測定用の変換IC U1に入力できる小さな電圧へ縮めるための抵抗。 | 型番記載 |  | R19
BOM-049 | 測定・制御 | R20 | 抵抗 | RG2012P-753-B-T5 | 75 kΩ 0.1% | 1 | 充電器の出力電圧の測定で、電圧を小さくする働きと抵抗一個あたりの電圧負担を、R19と分けるための抵抗。 | 型番記載 |  | R20
BOM-047 | 測定・制御 | R21 | 抵抗 | RG2012P-332-B-T5 | 3.3 kΩ 0.1% | 1 | 充電器の出力電圧を何分の一にして測定するかを、上側の抵抗と一緒に決めるための抵抗。 | 型番記載 |  | R21
BOM-049 | 測定・制御 | R22 | 抵抗 | RG2012P-753-B-T5 | 75 kΩ 0.1% | 1 | 蓄電池側の電圧を、測定用の変換IC U1に入力できる小さな電圧へ縮めるための抵抗。 | 型番記載 |  | R22
BOM-049 | 測定・制御 | R23 | 抵抗 | RG2012P-753-B-T5 | 75 kΩ 0.1% | 1 | 蓄電池側の電圧の測定で、電圧を小さくする働きと抵抗一個あたりの電圧負担を、R22と分けるための抵抗。 | 型番記載 |  | R23
BOM-047 | 測定・制御 | R24 | 抵抗 | RG2012P-332-B-T5 | 3.3 kΩ 0.1% | 1 | 蓄電池側の電圧を何分の一にして測定するかを、上側の抵抗と一緒に決めるための抵抗。 | 型番記載 |  | R24
BOM-046 | 測定・制御 | R25 | 抵抗 | RG2012P-101-B-T5 | 100 Ω 0.1% | 1 | 太陽光パネルの電流を測る信号に混ざった速い変動を弱め、測定用の変換IC U1へ渡すための抵抗。 | 型番記載 |  | R25
BOM-046 | 測定・制御 | R26 | 抵抗 | RG2012P-101-B-T5 | 100 Ω 0.1% | 1 | 充電電流を測る信号に混ざった速い変動を弱め、測定用の変換IC U1へ渡すための抵抗。 | 型番記載 |  | R26
BOM-027 | 測定・制御 | R27 | シャント抵抗 | CSS4J-4026R-1L00F | 1 mΩ・4端子 | 1 | パネル電流を測る既存の1 mΩシャント。逆流判定と順方向過電流検出の両方へ渡す。 | 型番記載 |  | PV_Reverse_Protection/R27
BOM-048 | 測定・制御 | R28 | 抵抗 | RG2012P-470-B-T5 | 47 Ω | 1 | 蓄電池の温度を測る信号から、測定時に混ざる非常に速い変動を弱めるための抵抗。 | 型番記載 |  | R28
BOM-048 | 測定・制御 | R29 | 抵抗 | RG2012P-470-B-T5 | 47 Ω | 1 | 放熱器の温度を測る信号から、測定時に混ざる非常に速い変動を弱めるための抵抗。 | 型番記載 |  | R29
BOM-035 | 測定・制御 | R30 | 抵抗 | ERJ3RSFR10V | 0.1 Ω 1% | 1 | 測定の基準電圧を作るU6が、出力側のコンデンサC31を接続した状態で働くよう、コンデンサ枝の性質を調整するための抵抗。 | 型番記載 |  | R30
BOM-008 | 測定・制御 | U1 | IC | MCP3208-CI/SL | 12 bit・8チャネル | 1 | 電圧・電流・温度の測定信号を、マイコンU7が計算に使える数値へ変える測定用IC。 | 型番記載 |  | U1
BOM-005 | 測定・制御 | U2 | IC | INA241A3IDDFR | 電流検出アンプ・50 V/V | 1 | 既存のパネル電流測定ICを共有し、逆流の有無を低電圧信号で判定できるようにする。 | 型番記載 |  | PV_Reverse_Protection/U2
BOM-005 | 測定・制御 | U3 | IC | INA241A3IDDFR | 電流検出アンプ・50 V/V | 1 | 主インダクタL1を通った充電側の電流を測るための増幅IC。 | 型番記載 |  | U3
BOM-013 | 測定・制御 | U4 | IC | TMP235A2DBZR | アナログ温度センサー | 1 | 電池付近の温度をマイコンへ知らせるための温度センサー。 | 型番記載 |  | U4
BOM-013 | 測定・制御 | U5 | IC | TMP235A2DBZR | アナログ温度センサー | 1 | 主電力段の放熱器付近の温度をマイコンへ知らせるための温度センサー。 | 型番記載 |  | U5
BOM-009 | 測定・制御 | U6 | IC | REF3025EAIDBZR | REF3025EAIDBZR / 2.5V | 1 | 電圧・電流の測定に使う、基準となる2.5 Vを作るIC。 | 型番記載 |  | U6
BOM-015 | 測定・制御 | U7 | マイコンボード | SC0918 | Raspberry Pi Pico W (SC0918) | 1 | 測定値を読み、太陽光充電の動かし方を決める制御用マイコン基板。 | 型番記載 |  | U7
BOM-025 | PV側保護 | L2 | インダクタ | 74437636356203 | 62 µH | 1 | 主電力段が入力側へ返すスイッチング電流の変動を和らげる62 µHの入力フィルタ用インダクタ。 | 型番記載 |  | PV_Reverse_Protection/L2
BOM-097 | PV側保護 | PV_CBST | コンデンサ | 未選定 | 10 µF | 1 | LTC7000AがMOSFETのゲートを充電するための浮動電源の蓄電コンデンサ。BSTと共通ソースTSの間に置く。25V級を候補とし、実効容量と充電時間を確認する。 | 型番未選定 | 公称値は図面の設定値。型番・定格・実装サイズは要選定。 25 V級は図面説明上の候補。 | PV_Reverse_Protection/PV_CBST
BOM-098 | PV側保護 | PV_CREV | コンデンサ | 未選定 | 10 nF / 16 V | 1 | 判定用基準電圧の局所ノイズを抑える。立上り待ち時間に含める。 | 型番未選定 | 公称値は図面の設定値。型番・定格・実装サイズは要選定。 | PV_Reverse_Protection/PV_CREV
BOM-099 | PV側保護 | PV_CTIME | コンデンサ | 未選定 | 1 nF / 25 V | 1 | 過電流遮断遅延の仮値。100k並列の影響も含めSOAと突入から要調整。 | 型番未選定 | 公称値は図面の設定値。型番・定格・実装サイズは要選定。 | PV_Reverse_Protection/PV_CTIME
BOM-100 | PV側保護 | PV_CVCC | コンデンサ | 未選定 | 1 µF / 25 V | 1 | 内部10V電源の局所バイパス。DCバイアス後の実効容量も確認する。 | 型番未選定 | 公称値は図面の設定値。型番・定格・実装サイズは要選定。 | PV_Reverse_Protection/PV_CVCC
BOM-101 | PV側保護 | PV_CVIN | コンデンサ | 未選定 | 100 nF / 200 V | 1 | 保護ICの高電圧入力電源を局所的に安定化する。 | 型番未選定 | 公称値は図面の設定値。型番・定格・実装サイズは要選定。 | PV_Reverse_Protection/PV_CVIN
BOM-102 | PV側保護 | PV_C_PV_U3 | コンデンサ | 未選定 | 100 nF / 16 V | 1 | PV_U3の電源ピンのすぐ近くに置くデカップリング。 | 型番未選定 | 公称値は図面の設定値。型番・定格・実装サイズは要選定。 | PV_Reverse_Protection/PV_C_PV_U3
BOM-103 | PV側保護 | PV_C_PV_U4 | コンデンサ | 未選定 | 100 nF / 16 V | 1 | PV_U4の電源ピンのすぐ近くに置くデカップリング。 | 型番未選定 | 公称値は図面の設定値。型番・定格・実装サイズは要選定。 | PV_Reverse_Protection/PV_C_PV_U4
BOM-104 | PV側保護 | PV_C_PV_U5 | コンデンサ | 未選定 | 100 nF / 16 V | 1 | PV_U5の電源ピンのすぐ近くに置くデカップリング。 | 型番未選定 | 公称値は図面の設定値。型番・定格・実装サイズは要選定。 | PV_Reverse_Protection/PV_C_PV_U5
BOM-105 | PV側保護 | PV_C_SLEW | コンデンサ | 未選定 | 100 nF | 1 | 保護MOSFETをONするときのゲート上昇を遅くし、入力コンデンサへの突入電流を抑えるための追加容量。 | 型番未選定 | 公称値は図面の設定値。型番・定格・実装サイズは要選定。 | PV_Reverse_Protection/PV_C_SLEW
BOM-106 | PV側保護 | PV_C_SUP | コンデンサ | 未選定 | 100 nF | 1 | PV_U6の電源を局所的に安定させるバイパスコンデンサ。 | 型番未選定 | 公称値は図面の設定値。型番・定格・実装サイズは要選定。 | PV_Reverse_Protection/PV_C_SUP
BOM-022 | PV側保護 | PV_D_BOOT | ダイオード | MMBD1501A | 仕様は型番・図面説明を参照 | 1 | 起動時に内部VCCからBSTのコンデンサへ充電する低漏れダイオード。 | 型番候補 | 図面で使用する候補。購入品としての確定・成立確認は未完了。 | PV_Reverse_Protection/PV_D_BOOT
BOM-024 | PV側保護 | PV_D_FLY | ダイオード | V20PW22-M3/I | 仕様は型番・図面説明を参照 | 1 | L2の電流が保護遮断直後も流れ続けるための迂回路を作り、正方向の過大電圧を抑えるダイオード。 | 型番候補 | 図面で使用する候補。購入品としての確定・成立確認は未完了。 | PV_Reverse_Protection/PV_D_FLY
BOM-019 | PV側保護 | PV_D_GS | ダイオード | BZT52H-C15,115 | 15 V・ゲートクランプ | 1 | 出力短絡や過電流時に共通ソースが下がっても、ゲートとソース間の電圧が上がりすぎないよう電流を逃がす。2個のMOSFETの外部ゲートとソースが共通なので1個で保護する。 | 型番記載 |  | PV_Reverse_Protection/PV_D_GS
BOM-024 | PV側保護 | PV_D_NEG | ダイオード | V20PW22-M3/I | 仕様は型番・図面説明を参照 | 1 | PV_FILTEREDがGNDより大きく負側へ振れるのを抑えるダイオード。 | 型番候補 | 図面で使用する候補。購入品としての確定・成立確認は未完了。 | PV_Reverse_Protection/PV_D_NEG
BOM-024 | PV側保護 | PV_D_TS | ダイオード | V20PW22-M3/I | 仕様は型番・図面説明を参照 | 1 | 2個の保護MOSFETの共通ソースとLTC7000AのTS端子が負電圧へ振れすぎるのを抑えるダイオード。 | 型番候補 | 図面で使用する候補。購入品としての確定・成立確認は未完了。 | PV_Reverse_Protection/PV_D_TS
BOM-001 | PV側保護 | PV_Q1 | MOSFET | IPB048N15N5LFATMA1 | 150 V・4.8 mΩ（25℃・VGS=10 V） | 1 | パネルと主電力段の間を開閉する保護用MOSFET。2個のソースを向かい合わせに接続し、OFF時に両方向の電流を遮断する構成。 | 型番記載 |  | PV_Reverse_Protection/PV_Q1
BOM-001 | PV側保護 | PV_Q2 | MOSFET | IPB048N15N5LFATMA1 | 150 V・4.8 mΩ（25℃・VGS=10 V） | 1 | パネルと主電力段の間を開閉する保護用MOSFET。2個のソースを向かい合わせに接続し、OFF時に両方向の電流を遮断する構成。 | 型番記載 |  | PV_Reverse_Protection/PV_Q2
BOM-054 | PV側保護 | PV_RAN | 抵抗 | 未選定 | 100 kΩ | 1 | 外部信号の開放時をLowにする仮値。 | 型番未選定 | 公称値は図面の設定値。型番・定格・実装サイズは要選定。 | PV_Reverse_Protection/PV_RAN
BOM-055 | PV側保護 | PV_RFLT | 抵抗 | 未選定 | 100 Ω | 1 | SNS-の短絡時電流を抑えるメーカー推奨の直列抵抗。 | 型番未選定 | 公称値は図面の設定値。型番・定格・実装サイズは要選定。 | PV_Reverse_Protection/PV_RFLT
BOM-056 | PV側保護 | PV_RFLT_PU | 抵抗 | 未選定 | 22 kΩ | 1 | FAULTオープンドレイン出力を3.3Vへプルアップする。 | 型番未選定 | 公称値は図面の設定値。型番・定格・実装サイズは要選定。 | PV_Reverse_Protection/PV_RFLT_PU
BOM-057 | PV側保護 | PV_RG | 抵抗 | 未選定 | 100 kΩ | 1 | ON側のゲート充電を遅くする抵抗。追加のPV_C_SLEWと組み合わせ、突入電流を抑える。OFF側のTGDN経路を同じ抵抗で遅くする接続ではない。 | 型番未選定 | 公称値は図面の設定値。型番・定格・実装サイズは要選定。 | PV_Reverse_Protection/PV_RG
BOM-058 | PV側保護 | PV_RGS | 抵抗 | 未選定 | 10 MΩ | 1 | ゲートとソース間の補助放電。12Vで1.2uA。チャージポンプの電流予算を圧迫しない高抵抗候補。 | 型番未選定 | 公称値は図面の設定値。型番・定格・実装サイズは要選定。 | PV_Reverse_Protection/PV_RGS
BOM-059 | PV側保護 | PV_RINP | 抵抗 | 未選定 | 100 kΩ | 1 | ドライバ入力が開放・ロジック電源停止したときLow側に置く。 | 型番未選定 | 公称値は図面の設定値。型番・定格・実装サイズは要選定。 | PV_Reverse_Protection/PV_RINP
BOM-060 | PV側保護 | PV_ROV_H | 抵抗 | 未選定 | 820 kΩ | 1 | 入力過電圧しきい値の上側分圧抵抗。部品単体の定格電圧も確認する。 | 型番未選定 | 公称値は図面の設定値。型番・定格・実装サイズは要選定。 | PV_Reverse_Protection/PV_ROV_H
BOM-061 | PV側保護 | PV_ROV_L | 抵抗 | 未選定 | 10 kΩ | 1 | OV停止公称100.43V、復帰92.13Vとなる仮値。 | 型番未選定 | 公称値は図面の設定値。型番・定格・実装サイズは要選定。 | PV_Reverse_Protection/PV_ROV_L
BOM-062 | PV側保護 | PV_RREARM | 抵抗 | 未選定 | 100 kΩ | 1 | 外部信号の開放時をLowにする仮値。 | 型番未選定 | 公称値は図面の設定値。型番・定格・実装サイズは要選定。 | PV_Reverse_Protection/PV_RREARM
BOM-063 | PV側保護 | PV_RREV_H | 抵抗 | 未選定 | 10.2 kΩ 0.1% | 1 | 逆流しきい値の上側分圧抵抗。 | 型番未選定 | 公称値は図面の設定値。型番・定格・実装サイズは要選定。 | PV_Reverse_Protection/PV_RREV_H
BOM-064 | PV側保護 | PV_RREV_L | 抵抗 | 未選定 | 9.8 kΩ 0.1% | 1 | 分圧で公称1.225Vを作る。理想値では-0.5Aに対応する。 | 型番未選定 | 公称値は図面の設定値。型番・定格・実装サイズは要選定。 | PV_Reverse_Protection/PV_RREV_L
BOM-065 | PV側保護 | PV_RRUN | 抵抗 | 未選定 | 100 kΩ | 1 | 外部信号の開放時をLowにする仮値。 | 型番未選定 | 公称値は図面の設定値。型番・定格・実装サイズは要選定。 | PV_Reverse_Protection/PV_RRUN
BOM-066 | PV側保護 | PV_RTIME | 抵抗 | 未選定 | 100 kΩ | 1 | TIMERの自動再試行を抑え、過電流後の停止を保持するメーカー回路例。 | 型番未選定 | 公称値は図面の設定値。型番・定格・実装サイズは要選定。 | PV_Reverse_Protection/PV_RTIME
BOM-067 | PV側保護 | PV_RUV_H | 抵抗 | 未選定 | 330 kΩ | 1 | 入力低電圧しきい値の上側分圧抵抗。部品単体の定格電圧も確認する。 | 型番未選定 | 公称値は図面の設定値。型番・定格・実装サイズは要選定。 | PV_Reverse_Protection/PV_RUV_H
BOM-068 | PV側保護 | PV_RUV_L | 抵抗 | 未選定 | 10.2 kΩ | 1 | UV開始公称約40.36V、停止約37.02Vとなる仮値。 | 型番未選定 | 公称値は図面の設定値。型番・定格・実装サイズは要選定。 | PV_Reverse_Protection/PV_RUV_L
BOM-069 | PV側保護 | PV_RVCCUV | 抵抗 | 未選定 | 113 kΩ | 1 | ゲート駆動電源のUVLOを公称約7.91Vへ設定する仮値。 | 型番未選定 | 公称値は図面の設定値。型番・定格・実装サイズは要選定。 | PV_Reverse_Protection/PV_RVCCUV
BOM-070 | PV側保護 | PV_R_SLEW | 抵抗 | 未選定 | 10 Ω | 1 | ゲートの傾きを設定する追加コンデンサへ急な電流が集中しにくくする直列抵抗。 | 型番未選定 | 公称値は図面の設定値。型番・定格・実装サイズは要選定。 | PV_Reverse_Protection/PV_R_SLEW
BOM-071 | PV側保護 | PV_R_SUP25 | 抵抗 | 未選定 | 21.3 kΩ | 1 | 2.5V基準監視の上側分圧抵抗。 | 型番未選定 | 公称値は図面の設定値。型番・定格・実装サイズは要選定。 | PV_Reverse_Protection/PV_R_SUP25
BOM-072 | PV側保護 | PV_R_SUP26 | 抵抗 | 未選定 | 10 kΩ | 1 | 2.5V基準監視の下側分圧抵抗。 | 型番未選定 | 公称値は図面の設定値。型番・定格・実装サイズは要選定。 | PV_Reverse_Protection/PV_R_SUP26
BOM-073 | PV側保護 | PV_R_SUP31 | 抵抗 | 未選定 | 31.2 kΩ | 1 | 3.3V監視の上側分圧抵抗。 | 型番未選定 | 公称値は図面の設定値。型番・定格・実装サイズは要選定。 | PV_Reverse_Protection/PV_R_SUP31
BOM-074 | PV側保護 | PV_R_SUP32 | 抵抗 | 未選定 | 10 kΩ | 1 | 3.3V監視の下側分圧抵抗。 | 型番未選定 | 公称値は図面の設定値。型番・定格・実装サイズは要選定。 | PV_Reverse_Protection/PV_R_SUP32
BOM-075 | PV側保護 | PV_R_SUP_PU | 抵抗 | 未選定 | 10 kΩ | 1 | 2本のRESETが解放されたときANALOG_OKをHighへ上げるプルアップ抵抗。 | 型番未選定 | 公称値は図面の設定値。型番・定格・実装サイズは要選定。 | PV_Reverse_Protection/PV_R_SUP_PU
BOM-007 | PV側保護 | PV_U1 | IC | LTC7000ARMSE#PBF | LTC7000A・高側ゲート駆動 | 1 | パネル側の遮断用MOSFET 2個を動かす保護付きゲートドライバ。 | 型番記載 |  | PV_Reverse_Protection/PV_U1
BOM-012 | PV側保護 | PV_U3 | IC | TLV3201AIDBVR | 高速コンパレータ | 1 | 逆流が設定値を超えたか比較し、プログラムを待たず停止条件を作る。 | 型番記載 |  | PV_Reverse_Protection/PV_U3
BOM-010 | PV側保護 | PV_U4 | IC | SN74LVC1G11DBVR | 3入力ANDゲート | 1 | 逆流なし・アナログ系正常・マイコン許可の3条件をまとめる。 | 型番記載 |  | PV_Reverse_Protection/PV_U4
BOM-011 | PV側保護 | PV_U5 | IC | SN74LVC1G74DCTR | Dフリップフロップ | 1 | 逆流などで一度停止した状態を保持し、電流ゼロに戻っただけでは再通電させない。 | 型番記載 |  | PV_Reverse_Protection/PV_U5
BOM-014 | PV側保護 | PV_U6 | IC | TPS37042BJOFDDFRQ1 | 2系統電圧監視 | 1 | 電流判定に使う3.3V電源と2.5V基準電源が使える状態か監視するIC。2系統とも正常のときだけANALOG_OKを許す。 | 型番記載 |  | PV_Reverse_Protection/PV_U6
BOM-096 | 電池側保護 | P_CHG | コンデンサ | CGA6P3C0G2E473J250AA | 47 nF | 1 | 保護用MOSFET P_Q1のゲート電圧が立ち上がる速さを調整し、起動時の急な電流を抑える設計に使うコンデンサ。 | 型番記載 |  | LTC4364_Protection/CHG_47nF
BOM-094 | 電池側保護 | P_COUT | コンデンサ | 100ZLH330MEFC12.5X35 | 330 µF | 1 | 保護回路を通ったバッテリー側に電荷を蓄え、その場所の電圧・電流の変化を受け止めるためのコンデンサ。 | 型番記載 |  | LTC4364_Protection/COUT_330uF
BOM-095 | 電池側保護 | P_CTMR | コンデンサ | CGA5L2C0G1H104J160AE | 100 nF | 1 | 保護ICが異常の継続時間を判断し、遮断へ移るタイミングを決めるためのコンデンサ。 | 型番記載 |  | LTC4364_Protection/CTMR_100nF
BOM-020 | 電池側保護 | P_D1 | ダイオード | CMZ5945B TR13 PBFREE | 68 V | 1 | 保護IC P_U1の電源電圧が上がりすぎるのを抑えるダイオード。 | 型番記載 |  | LTC4364_Protection/D1_Zener_68V
BOM-021 | 電池側保護 | P_D6 | ダイオード | DDZ9702T | 15 V | 1 | 保護用MOSFET P_Q1を駆動する電圧が、ソースに対して高くなりすぎるのを抑えるダイオード。 | 型番記載 |  | LTC4364_Protection/D6_Zener_15V
BOM-021 | 電池側保護 | P_D7 | ダイオード | DDZ9702T | 15 V | 1 | 逆流防止用MOSFET P_Q2のゲート電圧が、ソースに対して高くなりすぎるのを抑えるダイオード。 | 型番記載 |  | LTC4364_Protection/D7_Zener_15V
BOM-001 | 電池側保護 | P_Q1 | MOSFET | IPB048N15N5LFATMA1 | 150 V・4.8 mΩ（25℃・VGS=10 V） | 1 | 電池へ流す充電電流を通し、起動時や異常時には電流・電圧を制限するための保護用MOSFET。 | 型番候補 | 図面で使用する候補。購入品としての確定・成立確認は未完了。 | LTC4364_Protection/M1_FDB33N25_APPROX
BOM-001 | 電池側保護 | P_Q2 | MOSFET | IPB048N15N5LFATMA1 | 150 V・4.8 mΩ（25℃・VGS=10 V） | 1 | 電池から充電器へ向かう逆流を止めるための保護用MOSFET。 | 型番候補 | 図面で使用する候補。購入品としての確定・成立確認は未完了。 | LTC4364_Protection/M2_FDB3632_APPROX
BOM-053 | 電池側保護 | P_R1 | 抵抗 | TNPW0805243KBEEA | 243 kΩ | 1 | 充電器から保護回路へ入る電圧が、起動してよい範囲にあるかを判断するための分圧抵抗。 | 型番記載 |  | LTC4364_Protection/R1_205k
BOM-050 | 電池側保護 | P_R2 | 抵抗 | TNPW08052K74BEEA | 2.74 kΩ | 1 | 保護IC LTC4364が「電圧が低すぎる」と「高すぎる」を、別々の条件で判断できるようにするための抵抗。 | 型番記載 |  | LTC4364_Protection/R2_3k92
BOM-051 | 電池側保護 | P_R3 | 抵抗 | TNPW08054K99BEEA | 4.99 kΩ | 1 | 保護IC LTC4364へ渡す電圧検出信号を、共通GNDを基準として作るための抵抗。 | 型番記載 |  | LTC4364_Protection/R3_3k48
BOM-031 | 電池側保護 | P_R4 | 抵抗 | CRCW25126K80FKEG | 6.8 kΩ | 1 | 保護IC LTC4364へ給電しつつ、その電源を制限するツェナーダイオードP_D1へ電流が流れすぎないようにするための抵抗。 | 型番記載 |  | LTC4364_Protection/R4_2k2
BOM-032 | 電池側保護 | P_R5 | 抵抗 | CRCW080510R0FKEA | 10 Ω | 1 | 保護用MOSFET P_Q1のゲートに出入りする電流を調整し、局所的な電圧の振動を抑えるための抵抗。 | 型番記載 |  | LTC4364_Protection/R5_10ohm
BOM-052 | 電池側保護 | P_R7 | 抵抗 | TNPW0805236KBEEA | 236 kΩ | 1 | 保護回路が蓄電池側へ渡す電圧を上げすぎないよう、出力電圧を監視するための抵抗。 | 型番記載 |  | LTC4364_Protection/R7_226k
BOM-051 | 電池側保護 | P_R8 | 抵抗 | TNPW08054K99BEEA | 4.99 kΩ | 1 | 保護回路が出力電圧をどの高さで抑えるかを、P_R7と一緒に決めるための抵抗。 | 型番記載 |  | LTC4364_Protection/R8_4k02
BOM-033 | 電池側保護 | P_RFLT_PU | 抵抗 | CRCW080522K0FKEA | 22 kΩ | 1 | 保護IC LTC4364の故障通知を、マイコンがHigh・Lowとして読めるようにするための抵抗。 | 型番記載 |  | LTC4364_Protection/R_FLT_PULLUP_10k
BOM-034 | 電池側保護 | P_RSHDN_PD | 抵抗 | CRCW080547K0FKEA | 47 kΩ | 1 | マイコンがまだ指令を出していない間、保護IC LTC4364を停止側に置くための抵抗。 | 型番記載 |  | LTC4364_Protection/R_SHDN_PULLDOWN_47k
BOM-029 | 電池側保護 | P_RSHDN_SER | 抵抗 | CRCW08051K00FKEA | 1 kΩ | 1 | マイコンから保護IC LTC4364へ、主電力経路の動作許可・停止の指令を伝える接続に入れた抵抗。 | 型番記載 |  | LTC4364_Protection/R_EN_SERIES_1k
BOM-028 | 電池側保護 | P_RSNS | シャント抵抗 | WSL36372L700FEA | 2.7 mΩ | 1 | 保護IC LTC4364が、蓄電池へ流れる電流を制限するための判断に使う、小さな抵抗。 | 型番記載 |  | LTC4364_Protection/RSNS_10mOhm
BOM-006 | 電池側保護 | P_U1 | IC | LTC4364IMS-1#PBF | LTC4364-1・MSOP-16 | 1 | 充電器と電池の間で、逆流を防ぎ、異常時には順方向の充電も制限・停止する保護IC。 | 型番記載 |  | LTC4364_Protection/U1_LTC4364
BOM-112 | 外部機器 | BT1 | 蓄電池パック | LiTime 51.2V 100Ah | 51.2V 100Ah LiFePO4 | 1 | 太陽光で発電した電力を充電して蓄える、今回の設計対象の電池パック。 | 型番記載 |  | BT1
BOM-111 | 外部機器 | PV1 | 太陽電池モジュール | AXITEC AC-400MH/108V | 400 W・2枚直列のうち1枚 | 1 | 太陽光を電力へ変え、この充電器へ入力する太陽電池パネルの1枚目。 | 型番記載 |  | PV1
BOM-111 | 外部機器 | PV2 | 太陽電池モジュール | AXITEC AC-400MH/108V | 400 W・2枚直列のうち1枚 | 1 | 太陽光を電力へ変え、この充電器へ入力する太陽電池パネルの2枚目。 | 型番記載 |  | PV2
