MahleCube/solar-circuit/hardware/c07/pcb-wip/3dmodels/generated/ACPL_P346_SO6.step

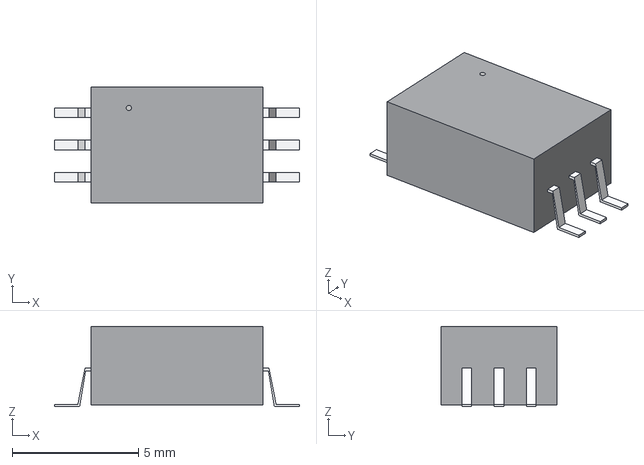
[picture p3: CAD file, 2026-11-06]
hardware/c07/pcb-wip/3dmodels/generated/ACPL_P346_SO6.step
9.70 x 4.58 x 3.18 mm
