MahleCube/solar-circuit/hardware/c07/pcb-wip/3dmodels/L1_assembly/Tamura_NAC20_0201_No265_FormedLeads_4x2.step

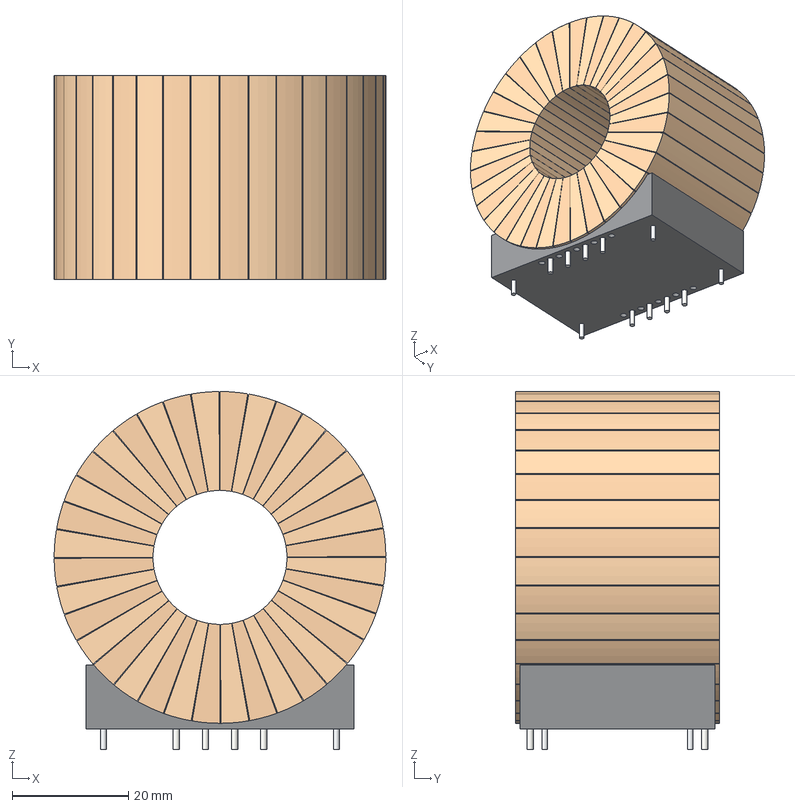
[picture p4: CAD file, 2026-11-06]
hardware/c07/pcb-wip/3dmodels/L1_assembly/Tamura_NAC20_0201_No265_FormedLeads_4x2.step
57.0 x 35.0 x 61.5 mm
