MahleCube/solar-circuit/hardware/c07/pcb-wip/3dmodels/manufacturer/WE_HCFT_74437636356203.stp

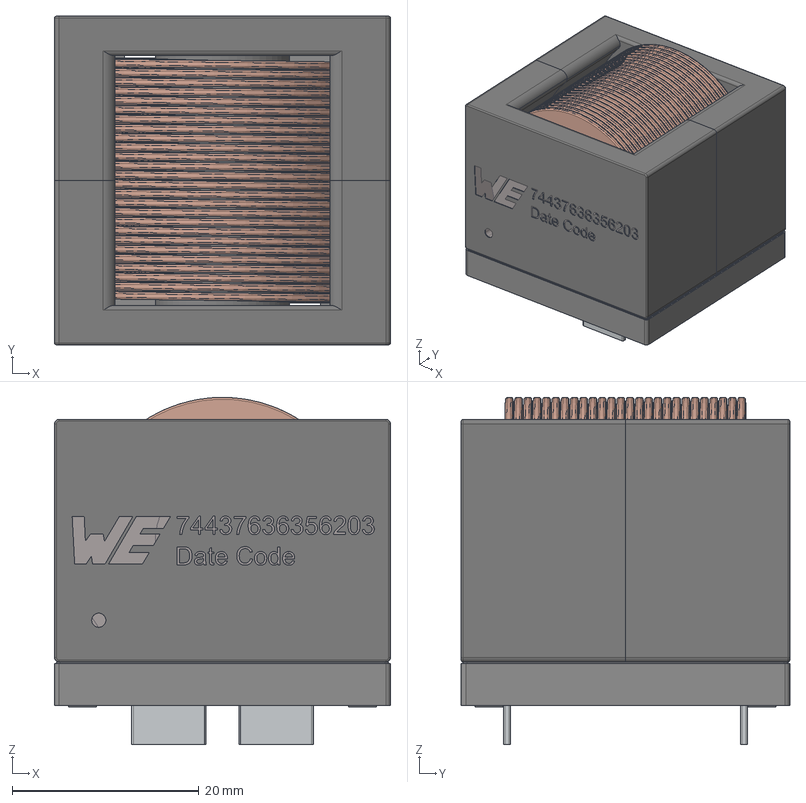
[picture p5: CAD file, 2026-11-06]
hardware/c07/pcb-wip/3dmodels/manufacturer/WE_HCFT_74437636356203.stp
36.0 x 35.2 x 37.2 mm
Base
Coil_6203_0.8
Core_B
Core_F
Glue
