MahleCube/solar-circuit/hardware/c07/pcb-wip/3dmodels/manufacturer/Vishay_SlimDPAK_TO-252AE_mounted.step

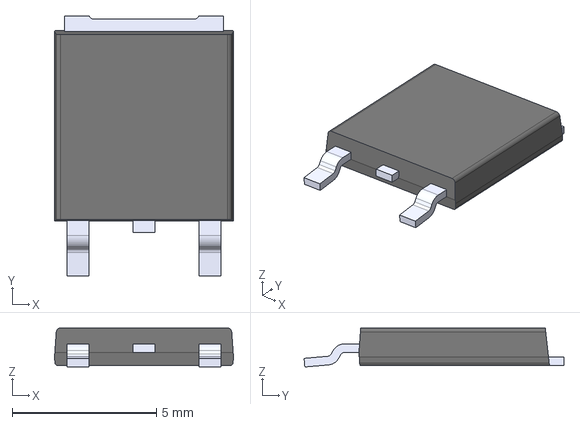
[picture p6: CAD file, 2026-11-06]
hardware/c07/pcb-wip/3dmodels/manufacturer/Vishay_SlimDPAK_TO-252AE_mounted.step
6.20 x 9.00 x 1.35 mm
