MahleCube/solar-circuit/hardware/c07/pcb-wip/3dmodels/generated/Bourns_CSS4J_4026R_1L00.step

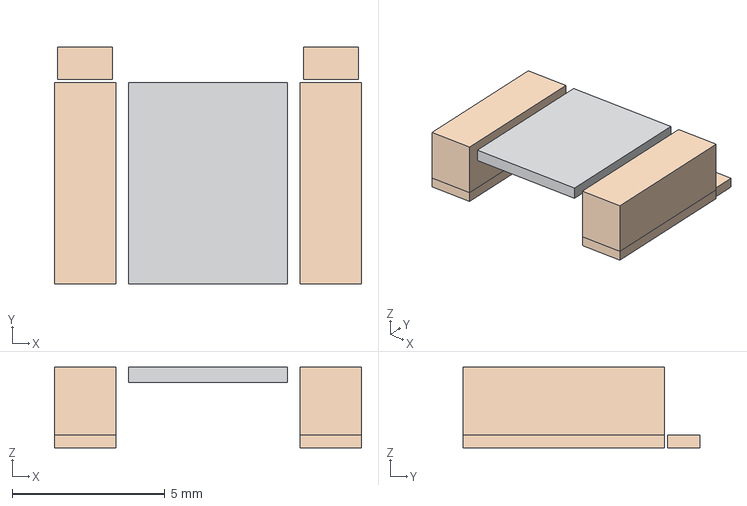
[picture p7: CAD file, 2026-11-06]
hardware/c07/pcb-wip/3dmodels/generated/Bourns_CSS4J_4026R_1L00.step
10.1 x 7.75 x 2.65 mm
