MahleCube/solar-circuit/hardware/c07/pcb-wip/3dmodels/generated/SCHURTER_SMD_SPT_5x20.step

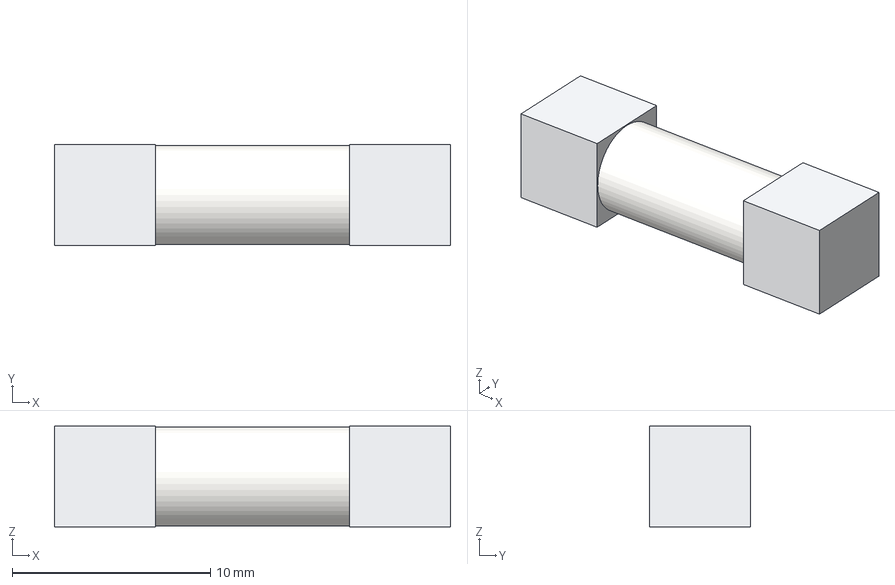
[picture p8: CAD file, 2026-11-06]
hardware/c07/pcb-wip/3dmodels/generated/SCHURTER_SMD_SPT_5x20.step
20.0 x 5.10 x 5.10 mm
