MahleCube/solar-circuit/hardware/c07/pcb-wip/3dmodels/generated/TRACO_TSR1WI_Case5.step

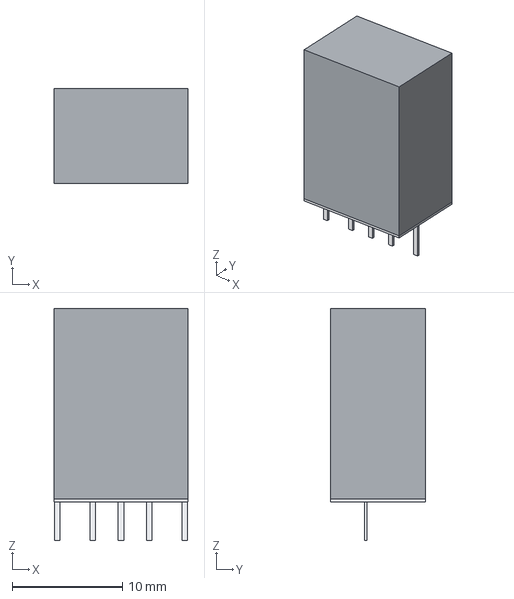
[picture p9: CAD file, 2026-11-06]
hardware/c07/pcb-wip/3dmodels/generated/TRACO_TSR1WI_Case5.step
12.1 x 8.60 x 21.0 mm
