MahleCube/solar-circuit/hardware/c07/pcb-wip/3dmodels/generated/KEMET_R76IR433050H3J_mounted.step

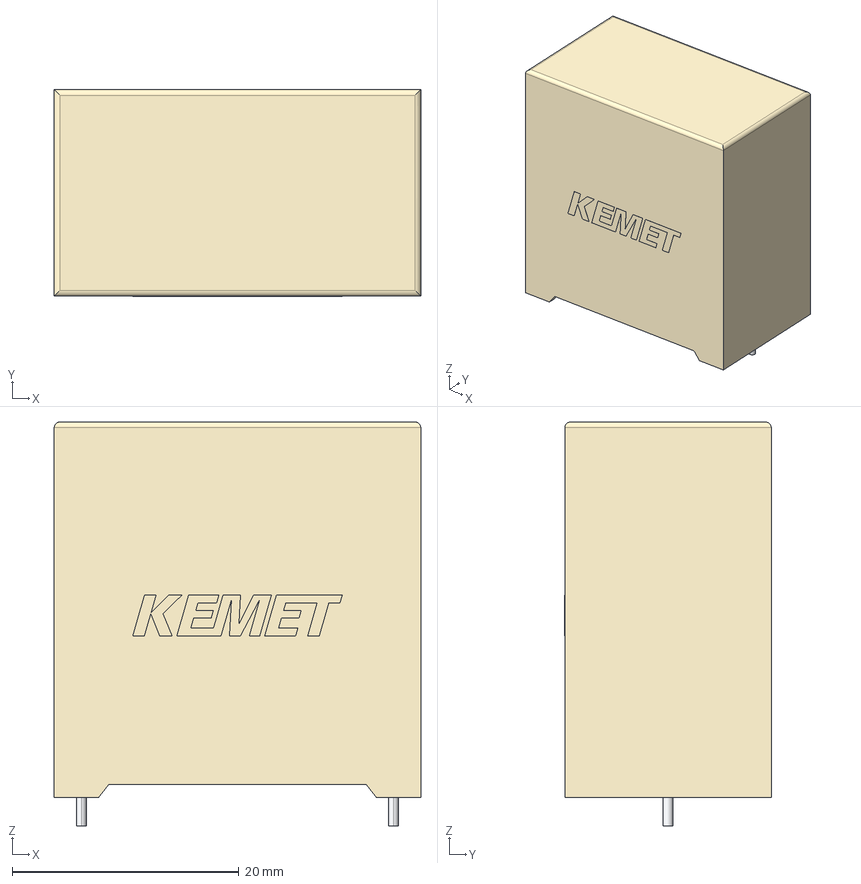
[picture p10: CAD file, 2026-11-06]
hardware/c07/pcb-wip/3dmodels/generated/KEMET_R76IR433050H3J_mounted.step
32.3 x 18.2 x 35.6 mm
