MahleCube/solar-circuit/hardware/c07/pcb-wip/3dmodels/generated/UCC14131_DWN0036A.step

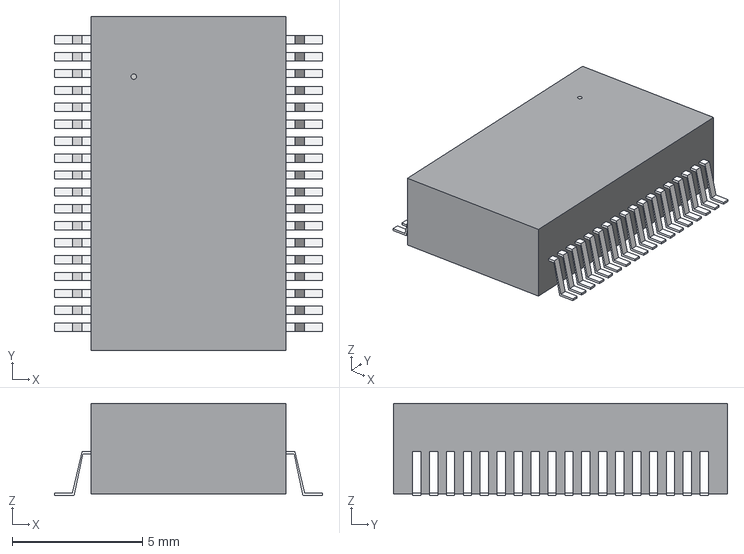
[picture p11: CAD file, 2026-11-06]
hardware/c07/pcb-wip/3dmodels/generated/UCC14131_DWN0036A.step
10.3 x 12.8 x 3.55 mm
