MahleCube/solar-circuit/docs/schematic/C07_Solar.pdf

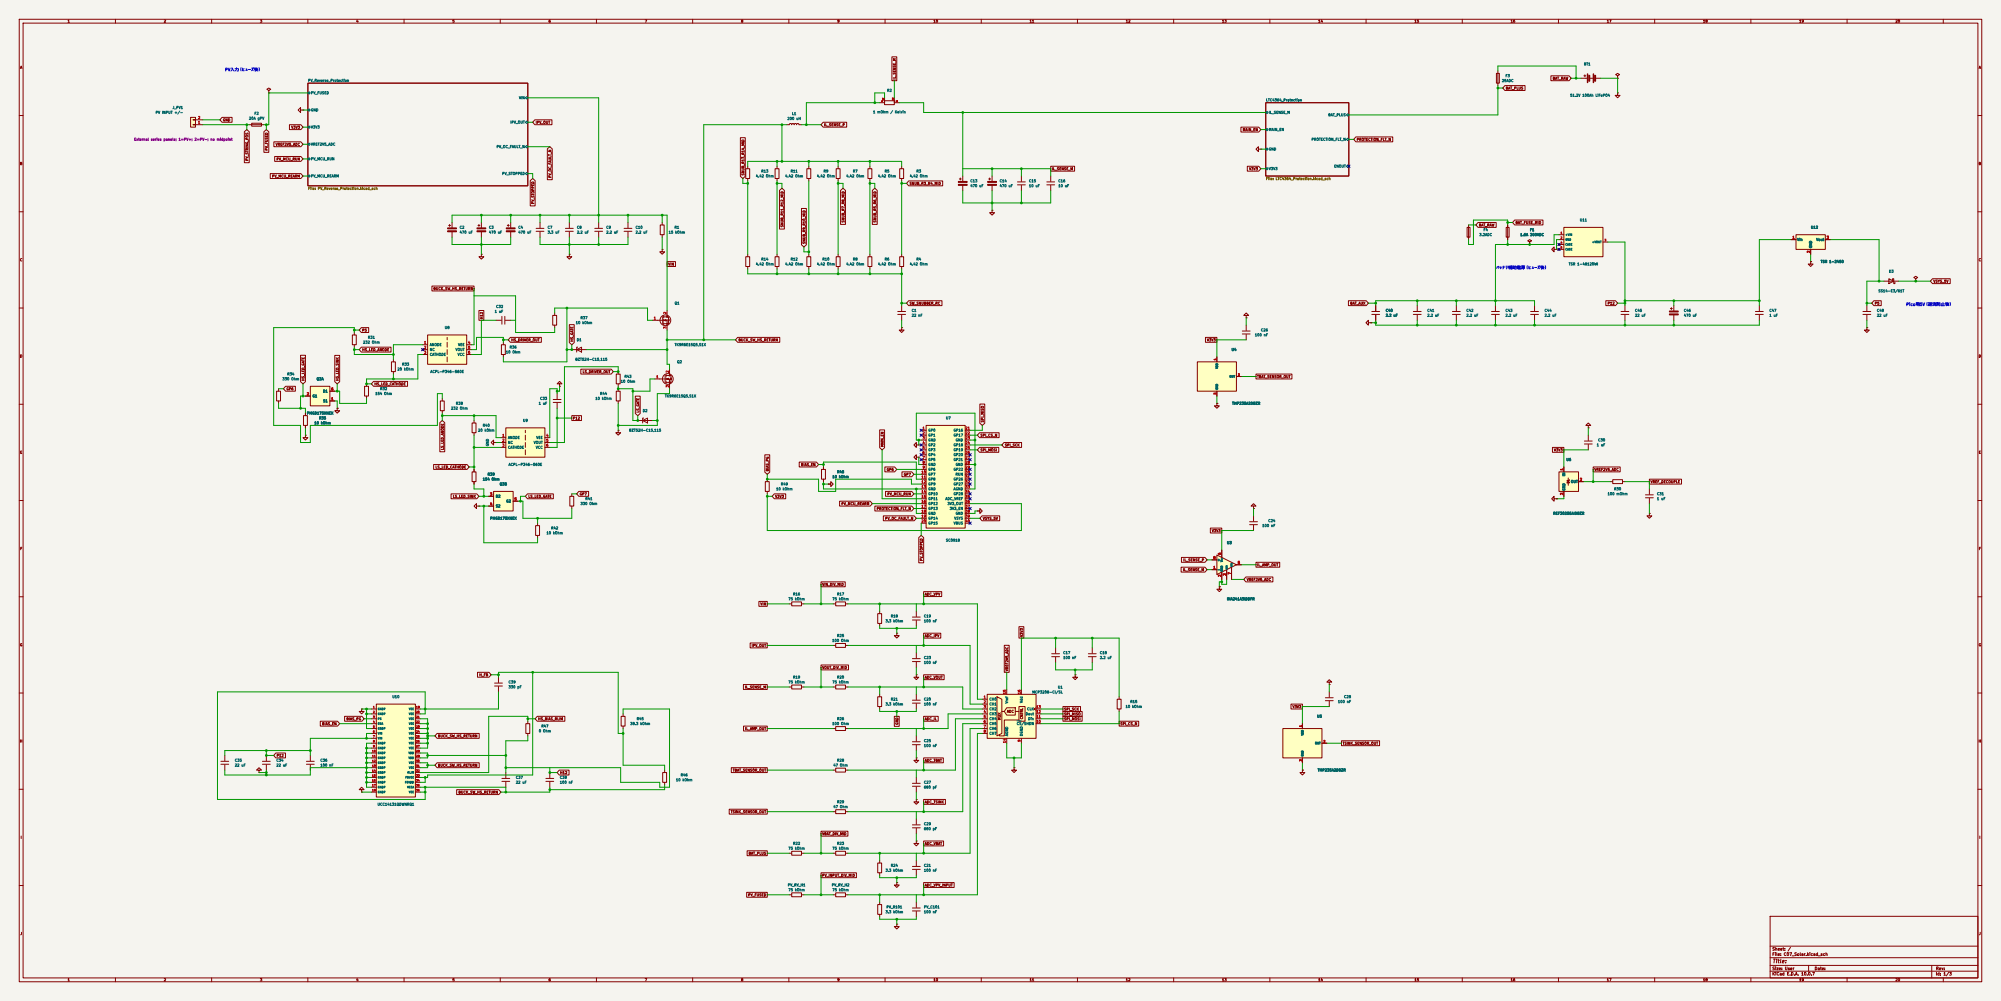
[picture p12: page 1]

External series panels; 1=PV+; 2=PV-; no midpoint

Size: User | Rev:
KiCad E.D.A. 10.0.7 | Id: 1/3

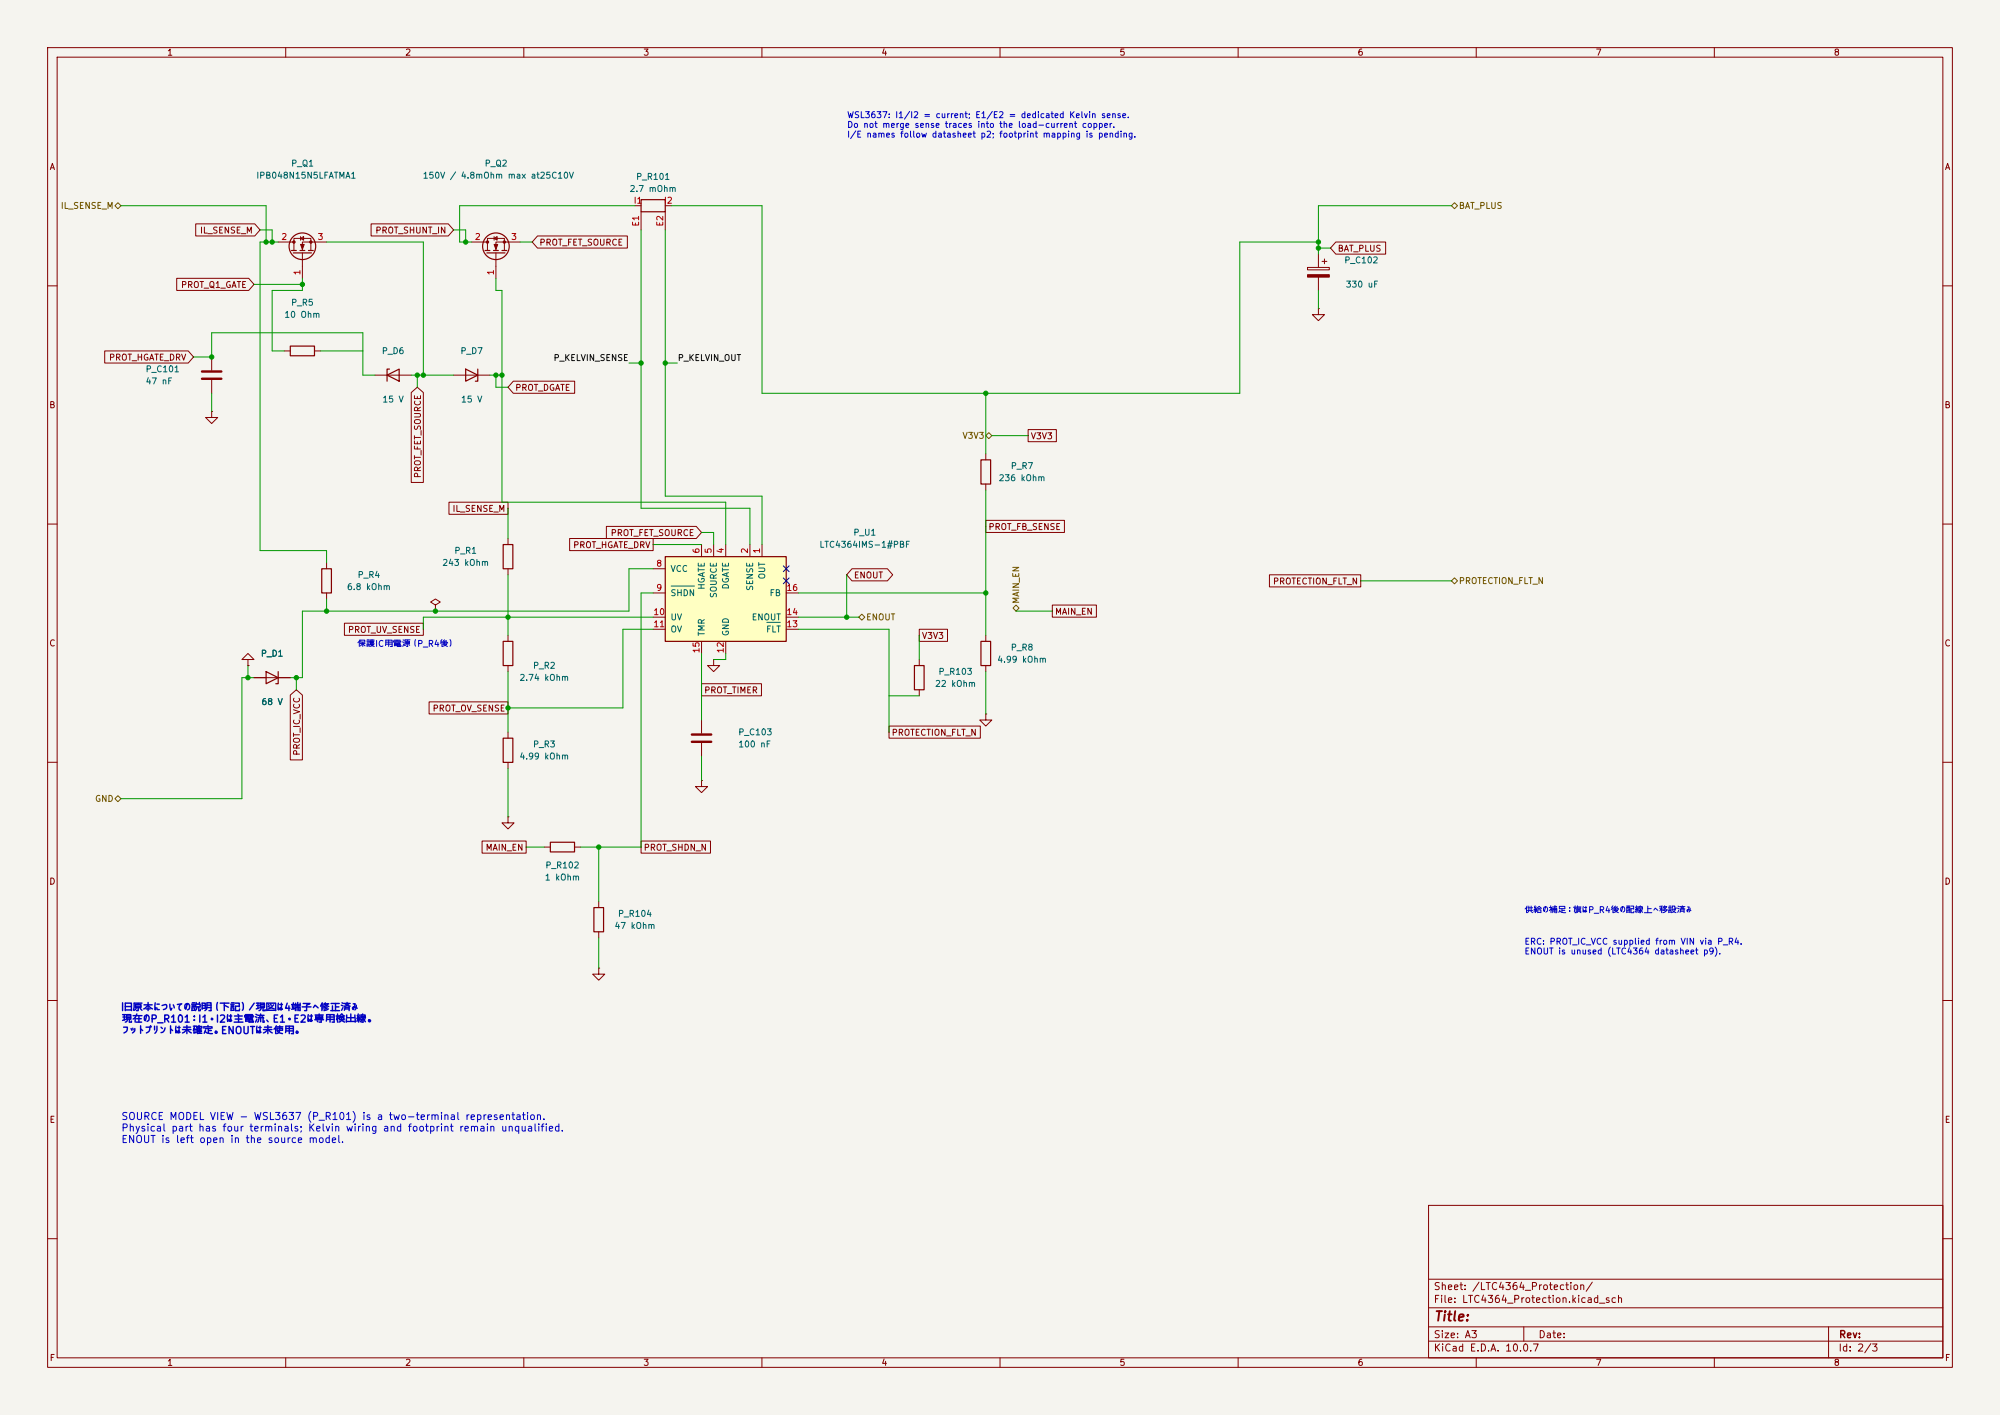
[picture p13: page 2]

WSL3637: I1/I2 = current; E1/E2 = dedicated Kelvin sense. Do not merge sense traces into the load-current copper.

I/E names follow datasheet p2; footprint mapping is pending.

SOURCE MODEL VIEW - WSL3637 (P_R101) is a two-terminal representation.
Physical part has four terminals; Kelvin wiring and footprint remain unqualified.

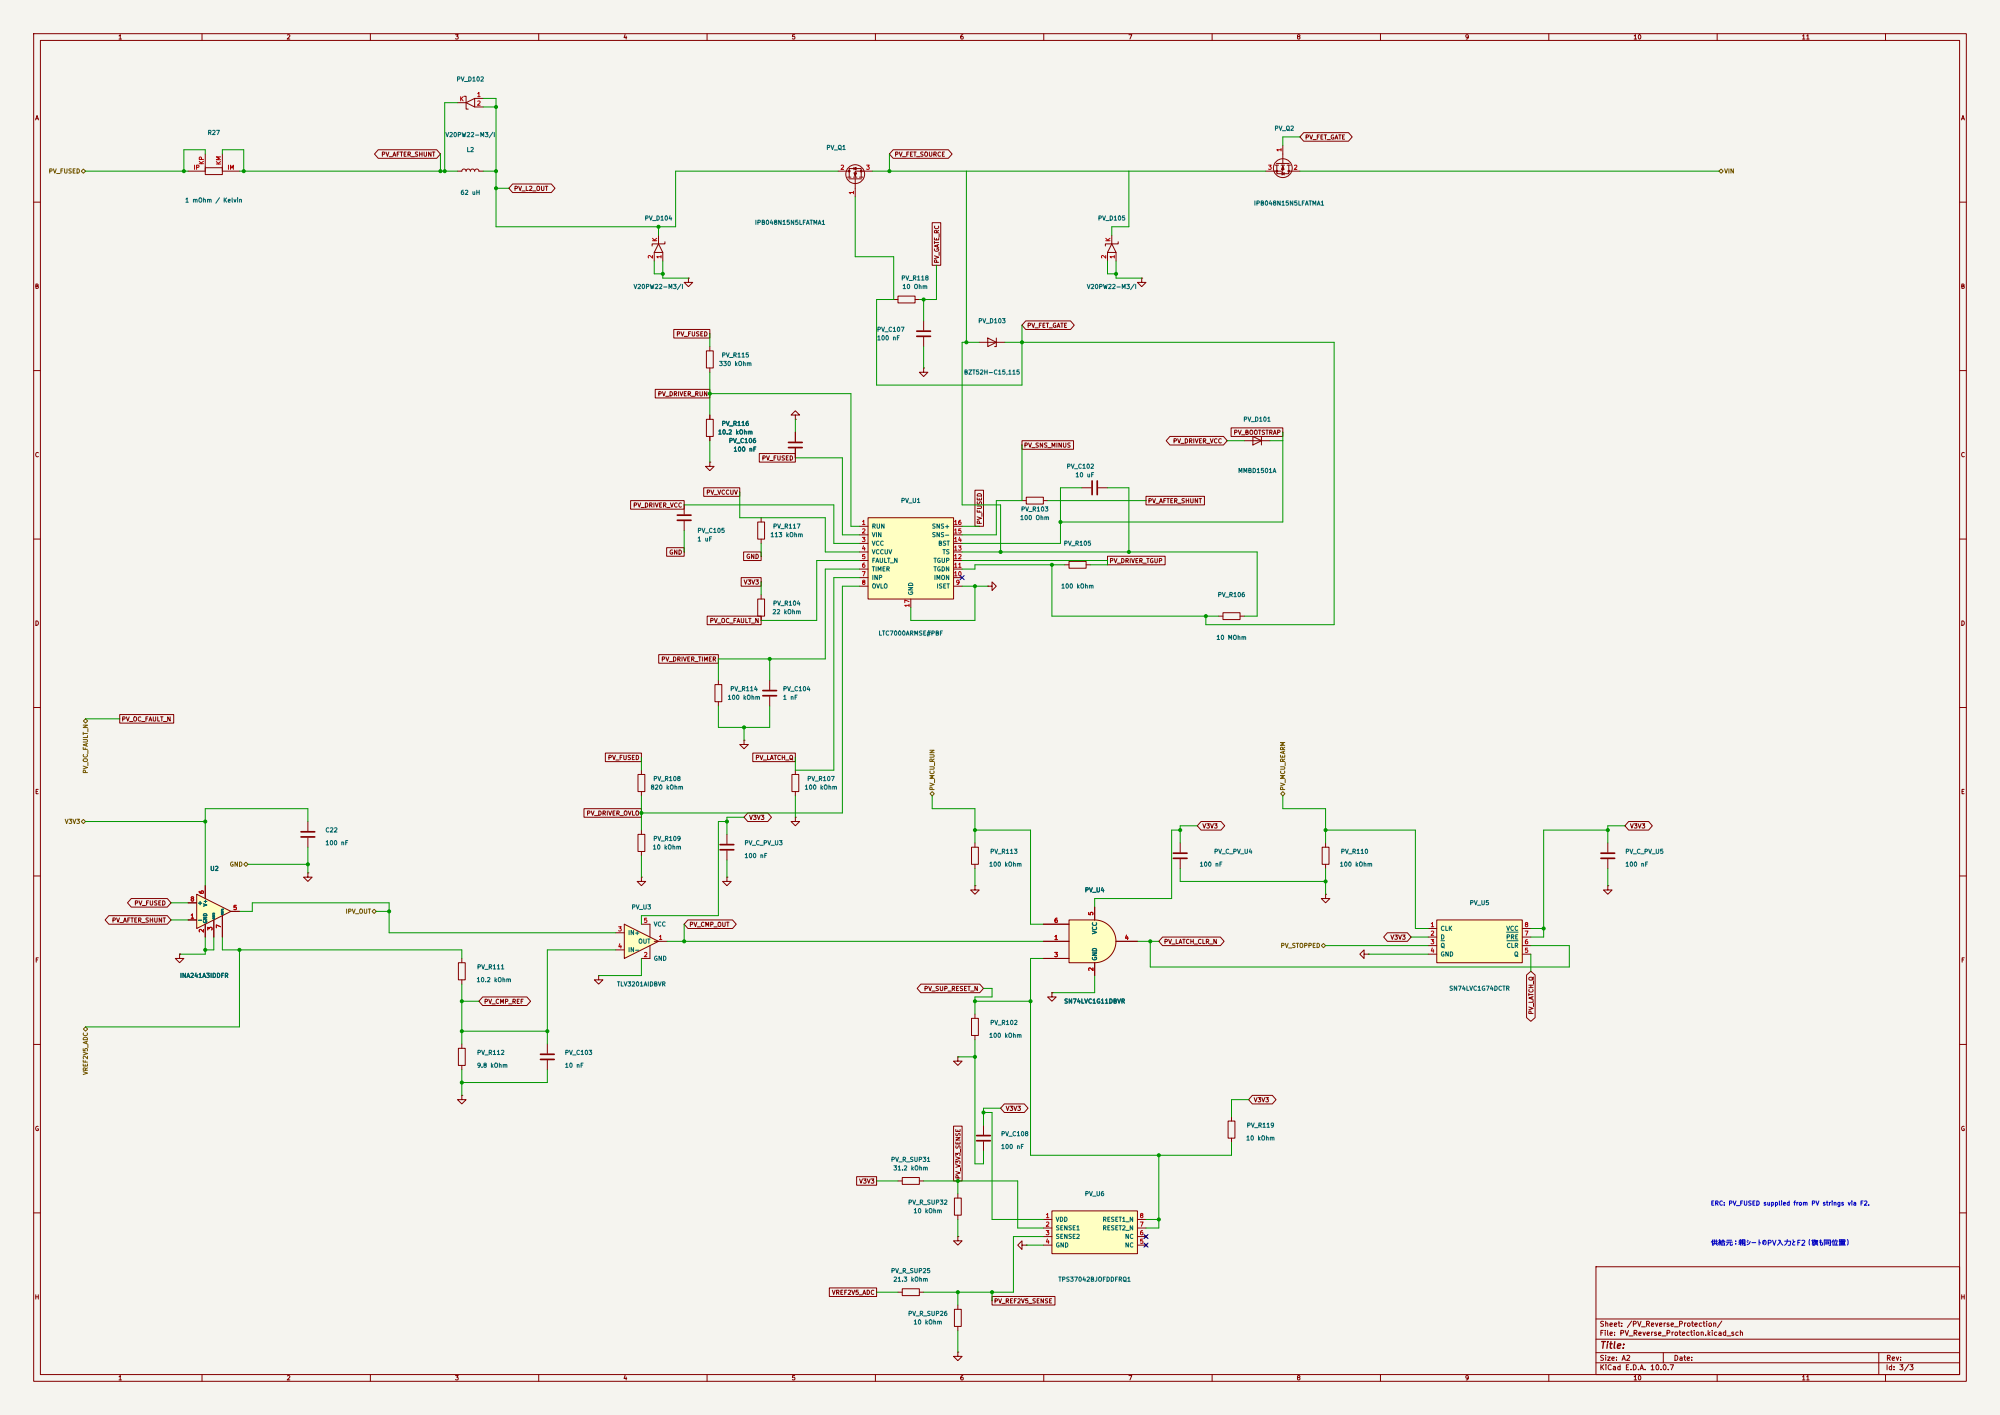
[picture p14: page 3]

ERC: PV_FUSED supplied from PV strings via F2.
