MahleCube/solar-circuit/firmware/r04/src/core/c07_control.c

#include "c07_control.h"
#include <math.h>
#include <stddef.h>
#include <string.h>

#ifndef C07_SELECTION_DIAGNOSTICS
#define C07_SELECTION_DIAGNOSTICS 1
#endif

#define R(x) ((c07_real_t)(x))
static c07_real_t lo(c07_real_t a,c07_real_t b){return a<b?a:b;}
static c07_real_t hi(c07_real_t a,c07_real_t b){return a>b?a:b;}
static c07_real_t absr(c07_real_t a){return a<R(0)?-a:a;}
static c07_real_t clamp(c07_real_t x,c07_real_t a,c07_real_t b){return hi(a,lo(b,x));}
/* Integer microsecond timestamps can differ by one tick at a fixed cadence.
 * Cache each actual interval separately; do not round a measured dt. */
static unsigned period_slot(uint32_t nominal,uint32_t measured){
    if(measured==nominal)return 0;
    if(measured<nominal&&nominal-measured==1)return 1;
    if(measured>nominal&&measured-nominal==1)return 2;
    return 3;
}
/* Timers saturate instead of wrapping during indefinite unsettled operation. */
static uint32_t add_time(uint32_t a,uint32_t b){return UINT32_MAX-a<b?UINT32_MAX:a+b;}
static void pi_track(c07_pi *p,c07_real_t output,c07_real_t error,c07_real_t ff){
    p->integral=output-ff-p->kp*error;
}
static c07_real_t pi_step(c07_pi *p,c07_real_t error,c07_real_t dt,
                         c07_real_t lower,c07_real_t upper,c07_real_t ff){
    c07_real_t inc=p->ki*error*dt;
    c07_real_t base=ff+p->kp*error+p->integral;
    /* Consume available headroom instead of discarding a whole increment.
     * When the proportional term alone is already outside the bounds, hold
     * the worsening integral; never move it backwards just to cancel P. */
    if(inc>R(0))inc=lo(inc,hi(R(0),upper-base));
    else if(inc<R(0))inc=hi(inc,lo(R(0),lower-base));
    p->integral+=inc;
    return clamp(ff+p->kp*error+p->integral,lower,upper);
}
static void clear_window(c07_mppt *m){
    m->settled_us=0; m->window_us=0; m->power_sum=R(0); m->voltage_sum=R(0);m->current_sum=R(0);
}
static void mppt_reset(c07_controller *s,c07_real_t voc,c07_real_t minimum){
    c07_mppt *m=&s->mppt; const c07_config *c=&s->cfg;
    memset(m,0,sizeof(*m)); m->maximum=c->MPPT_REFERENCE_MAX_V;
    c07_real_t initial_max=hi(minimum,lo(m->maximum,voc-c->MPPT_VOC_MARGIN_V));
    m->target=clamp(voc*c->MPPT_INITIAL_FRACTION,minimum,initial_max);
    m->direction=-1;m->probe_direction=-1;m->step_v=c->MPPT_STEP_MIN_V;
}
static void mppt_update_legacy(c07_controller *s,c07_real_t voltage,c07_real_t power,
                        c07_real_t minimum,uint32_t dt_us,bool limited,bool settled){
    c07_mppt *m=&s->mppt; const c07_config *c=&s->cfg;
    if(minimum>m->maximum) limited=true;
    c07_real_t bounded=clamp(m->target,minimum,hi(minimum,m->maximum));
    if(bounded!=m->target){
        m->target=bounded; m->have_previous_power=false; m->elapsed_us=0; clear_window(m);
    }
    if(limited){m->have_previous_power=false;m->elapsed_us=0;clear_window(m);return;}
    m->elapsed_us=add_time(m->elapsed_us,dt_us);
    if(!settled){clear_window(m);return;}
    m->settled_us=add_time(m->settled_us,dt_us);
    if(m->settled_us<c->MPPT_SETTLE_US) return;
    m->power_sum+=power*R(dt_us);m->voltage_sum+=voltage*R(dt_us);
    m->window_us=add_time(m->window_us,dt_us);
    if(m->elapsed_us<c->MPPT_PERIOD_US || m->window_us<c->MPPT_WINDOW_US) return;
    c07_real_t mean=m->power_sum/R(m->window_us);
    if(m->have_previous_power){
        c07_real_t change=mean-m->previous_power;
        if(change < -c->POWER_DEADBAND_W) m->direction=-m->direction;
        c07_real_t scale=absr(change)/hi(absr(m->previous_power),c->MPPT_POWER_FLOOR_W);
        m->step_v=clamp(c->MPPT_STEP_MIN_V+c->MPPT_STEP_GAIN_V*scale,
                       c->MPPT_STEP_MIN_V,c->MPPT_STEP_MAX_V);
        /* Keep the power anchor inside the deadband. Replacing it after
         * every tiny step hides a cumulative downhill excursion. */
        if(absr(change)>c->POWER_DEADBAND_W)m->previous_power=mean;
    } else {m->step_v=c->MPPT_STEP_MIN_V;m->previous_power=mean;m->have_previous_power=true;}
    m->target=clamp(m->target+R(m->direction)*m->step_v,minimum,m->maximum);
    if(m->target<=minimum){m->direction=1;m->previous_power=mean;}
    else if(m->target>=m->maximum){m->direction=-1;m->previous_power=mean;}
    m->updates++;m->elapsed_us=0;clear_window(m);
}

/* The selectable methods use paired raw V/I window averages, distinct from
 * the legacy mean(VI) path. IncCond uses three time-bracketed windows below;
 * P&O compares consecutive windows. Neither receives a model MPP. */
static c07_real_t selection_step(const c07_config *c,c07_real_t dp,c07_real_t dv,
                                 c07_real_t current,c07_real_t prior_power){
    if(c->MPPT_STEP_MODE==0)return c->MPPT_STEP_MIN_V;
    if(c->MPPT_STEP_MODE==1){
        c07_real_t scale=absr(dp)/hi(absr(prior_power),c->MPPT_POWER_FLOOR_W);
        return clamp(c->MPPT_STEP_MIN_V+c->MPPT_STEP_GAIN_V*scale,
                     c->MPPT_STEP_MIN_V,c->MPPT_STEP_MAX_V);
    }
    if(absr(dv)<=c->MPPT_VOLTAGE_DEADBAND_V)return c->MPPT_STEP_MIN_V;
    c07_real_t normalized=absr(dp/dv)/hi(absr(current),c->MPPT_SLOPE_CURRENT_FLOOR_A);
    return clamp(c->MPPT_STEP_GAIN_V*normalized,c->MPPT_STEP_MIN_V,c->MPPT_STEP_MAX_V);
}
static int inccond_direction(const c07_config *c,c07_real_t voltage,c07_real_t current,
                            c07_real_t dv,c07_real_t di,c07_real_t *signal){
    /* Standard current-point incremental conductance, without division:
     * S=I_k*dV+V_k*dI. sign(dP/dV) approximately sign(S)*sign(dV).
     * S differs from discrete delta(V*I) by dV*dI; that finite-step term is
     * deliberately not hidden by replacing current-point terms by midpoints. */
    *signal=current*dv+voltage*di;
    if(absr(dv)<=c->MPPT_VOLTAGE_DEADBAND_V){
        /* Current changing at indistinguishable voltage is not evidence
         * of a spatial I-V slope. Re-probe locally instead of following
         * irradiance/quantisation as an MPPT direction. */
        return 0;
    }
    if(absr(*signal)<=c->POWER_DEADBAND_W)return 0;
    return ((*signal>R(0))==(dv>R(0)))?1:-1;
}
static void selection_anchor(c07_mppt *m,c07_real_t v,c07_real_t i,c07_real_t p){
    m->previous_voltage=v;m->previous_current=i;m->previous_power=p;m->have_previous_power=true;
}
static void inccond_bracket(const c07_config *c,c07_mppt *m,c07_real_t minimum,
                           c07_real_t v,c07_real_t i,uint64_t sample_us){
    c07_real_t old=m->target;
    if(m->probe_active==0){
        selection_anchor(m,v,i,v*i);m->previous_sample_us=sample_us;
        m->probe_center_v=old;
        /* At low current a 0.5V perturbation may not cross one ADC current
         * code. Reuse the configured comparison resolution to choose a
         * bounded local excitation; this is not a global voltage sweep. */
        c07_real_t resolution=c->POWER_DEADBAND_W+absr(v)*c->MPPT_CURRENT_DEADBAND_A;
        c07_real_t width=clamp(resolution/hi(absr(i),c->MPPT_SLOPE_CURRENT_FLOOR_A),
                              lo(c->MPPT_STEP_MAX_V,c->MPPT_PROBE_MAX_V),c->MPPT_PROBE_MAX_V);
        int side=m->probe_direction<0?-1:1;
        c07_real_t b=clamp(old+R(side)*width,minimum,m->maximum);
        c07_real_t other=clamp(old-R(side)*width,minimum,m->maximum);
        if(absr(b-old)<absr(other-old)){b=other;side=-side;}
        m->probe_excitation_v=absr(b-old);
        m->probe_direction=-side;m->target=b;m->probe_active=1;m->reprobes++;
    } else if(m->probe_active==1){
        m->middle_voltage=v;m->middle_current=i;m->middle_sample_us=sample_us;
        m->target=clamp(m->probe_center_v,minimum,m->maximum);m->probe_active=2;
    } else {
        int direction=0;
        if(m->previous_sample_us<m->middle_sample_us&&m->middle_sample_us<sample_us){
            c07_real_t w=R(m->middle_sample_us-m->previous_sample_us)/R(sample_us-m->previous_sample_us);
            c07_real_t va=m->previous_voltage+w*(v-m->previous_voltage);
            c07_real_t ia=m->previous_current+w*(i-m->previous_current);
            c07_real_t dv=m->middle_voltage-va,di=m->middle_current-ia;
            c07_real_t dp=m->middle_voltage*m->middle_current-va*ia;
            direction=inccond_direction(c,m->middle_voltage,m->middle_current,dv,di,&m->last_signal);
            m->step_v=selection_step(c,dp,dv,m->middle_current,va*ia);
            /* Unresolved low-current contrast with incomplete measured
             * voltage travel is not evidence that the MPP was reached.
             * Reacquire a finite longer OUTER window; the PI keeps running. */
            bool unresolved=absr(di)<c->MPPT_CURRENT_DEADBAND_A
                &&absr(m->last_signal)<=c->POWER_DEADBAND_W;
            if(!unresolved)m->probe_observation_us=0;
            else if(!m->fast_probe&&absr(dv)+c->MPPT_SETTLE_V<m->probe_excitation_v){
                uint32_t base=add_time(c->MPPT_SETTLE_US,c->MPPT_WINDOW_US);
                if(m->probe_observation_us>base)base=m->probe_observation_us;
                c07_real_t wanted=absr(di)>R(0)
                    ?R(base)*c->MPPT_CURRENT_DEADBAND_A/absr(di):R(c->MPPT_MAX_HOLD_US);
                wanted=lo(R(c->MPPT_MAX_HOLD_US),hi(R(add_time(base,c->CONTROL_PERIOD_US)),wanted));
                m->probe_observation_us=(uint32_t)wanted;
            }
            if(absr(dv)>c->MPPT_VOLTAGE_DEADBAND_V){
                m->local_conductance=di/dv;m->gradient_valid=true;
            }
        }
        m->target=clamp(m->probe_center_v+R(direction)*m->step_v,minimum,m->maximum);
        if(direction)m->direction=direction;
        m->probe_active=0;m->have_previous_power=false;m->updates++;
    }
    if(m->target!=old)m->moves++;else m->holds++;
    m->elapsed_us=0;clear_window(m);
}
static void selection_decide(const c07_config *c,c07_mppt *m,c07_real_t minimum,uint64_t sample_us){
    c07_real_t v=m->voltage_sum/R(m->window_us),i=m->current_sum/R(m->window_us),p=v*i;
    m->last_mean_voltage=v;m->last_mean_current=i;m->last_mean_power=p;
    #if C07_SELECTION_DIAGNOSTICS
    m->last_mean_instant_power=m->power_sum/R(m->window_us);
#endif
    m->last_signal=R(0);
    if(c->MPPT_METHOD==2){inccond_bracket(c,m,minimum,v,i,sample_us);return;}
    int direction=m->direction;
    if(!m->have_previous_power){m->step_v=c->MPPT_STEP_MIN_V;selection_anchor(m,v,i,p);}
    else {
        c07_real_t dp=p-m->previous_power,dv=v-m->previous_voltage;
        m->step_v=selection_step(c,dp,dv,i,m->previous_power);
        m->last_signal=dp;
        if(dp < -c->POWER_DEADBAND_W)direction=-direction;
        if(absr(dp)>c->POWER_DEADBAND_W)selection_anchor(m,v,i,p);
    }
    c07_real_t old=m->target;
    if(direction!=0){m->direction=direction;m->target=clamp(old+R(direction)*m->step_v,minimum,m->maximum);}
    if(m->target!=old)m->moves++;else m->holds++;
    if(m->target<=minimum){m->direction=1;selection_anchor(m,v,i,p);}
    else if(m->target>=m->maximum){m->direction=-1;selection_anchor(m,v,i,p);}
    m->updates++;m->elapsed_us=0;clear_window(m);
}
void c07_mppt_invalidate(c07_controller *s,bool clear_anchor){
    s->async.epoch++;
    if(s->async.pending)s->async.invalidated++;
    s->async.pending=false;
    clear_window(&s->mppt);
    if(clear_anchor){
        if(s->mppt.probe_active)s->mppt.target=s->mppt.probe_center_v;
        s->mppt.have_previous_power=false;s->mppt.probe_active=0;
        s->mppt.unresolved_us=0;s->mppt.probe_center_v=R(0);s->mppt.probe_direction=-1;
        s->mppt.gradient_valid=false;
    }
}
bool c07_mppt_begin(c07_controller *s,c07_mppt_job *job){
    if(!s||!job)return false;
    uint32_t seq=atomic_load_explicit(&s->async.request_seq,memory_order_acquire);
    if(!seq||(seq&1u)||seq==s->async.background_seen)return false;
    *job=s->async.request;
    atomic_thread_fence(memory_order_acquire);
    if(seq!=atomic_load_explicit(&s->async.request_seq,memory_order_acquire))return false;
    s->async.background_seen=seq;
    return true;
}
bool c07_mppt_compute(const c07_config *c,const c07_mppt_job *job,c07_mppt_result *result){
    if(!c||!job||!result)return false;
    result->job=*job;result->valid=false;
    if(!job->state.window_us)return false;
    selection_decide(c,&result->job.state,job->minimum,
                     job->captured_us-job->state.window_us/2u);
    c07_mppt *m=&result->job.state;
    result->valid=isfinite(m->target)&&isfinite(m->step_v)&&isfinite(m->previous_power)
        &&isfinite(m->previous_voltage)&&isfinite(m->previous_current)&&isfinite(m->last_signal)
        &&isfinite(m->probe_center_v)&&isfinite(m->middle_voltage)&&isfinite(m->middle_current)
        &&(!m->gradient_valid||isfinite(m->local_conductance))&&m->probe_active<=2;
    return result->valid;
}
void c07_mppt_publish(c07_controller *s,const c07_mppt_result *result){
    if(!s||!result)return;
    atomic_store_explicit(&s->async.result_seq,result->job.request_id-1u,memory_order_relaxed);
    atomic_thread_fence(memory_order_release);
    s->async.result=*result;
    atomic_store_explicit(&s->async.result_seq,result->job.request_id,memory_order_release);
}
bool c07_mppt_background(c07_controller *s){
    c07_mppt_job job;c07_mppt_result result;
    if(!c07_mppt_begin(s,&job))return false;
    c07_mppt_compute(&s->cfg,&job,&result);c07_mppt_publish(s,&result);return true;
}
static void mppt_update_selection(c07_controller *s,c07_real_t voltage,c07_real_t current,
                                  c07_real_t minimum,uint32_t dt_us,bool limited,bool settled){
    c07_mppt *m=&s->mppt;const c07_config *c=&s->cfg;c07_mppt_mailbox *a=&s->async;
    if(minimum>m->maximum)limited=true;
    c07_real_t bounded=clamp(m->target,minimum,hi(minimum,m->maximum));
    if(bounded!=m->target){c07_mppt_invalidate(s,true);m->target=bounded;m->elapsed_us=0;}
    if(limited){c07_mppt_invalidate(s,true);m->elapsed_us=0;s->mppt_raw_valid=false;return;}
    /* Reject a discontinuity inconsistent with the most recent local I-V
     * slope. A smooth irradiance drift is handled by A-B-A interpolation;
     * an abrupt step must not be interpreted as that linear drift. This
     * only restarts the local comparison; current/PWM control continues. */
    bool jump=false;
    if(c->MPPT_METHOD==2&&s->mppt_raw_valid&&m->gradient_valid){
        c07_real_t innovation=current-s->mppt_previous_raw_i-
                               m->local_conductance*(voltage-s->mppt_previous_raw_v);
        c07_real_t bound=hi(R(4)*c->MPPT_CURRENT_DEADBAND_A,
            c->MPPT_JUMP_CURRENT_FRACTION*hi(absr(current),absr(s->mppt_previous_raw_i)));
        jump=absr(innovation)>bound;
    }
    s->mppt_previous_raw_v=voltage;s->mppt_previous_raw_i=current;s->mppt_raw_valid=true;
    if(jump){
        s->mppt_discontinuities++;s->mppt_fast_until_us=a->clock_us+c->MPPT_MAX_HOLD_US;
        /* The comparison crossed a discontinuity; its samples are invalid.
         * Keep the last accepted local slope for monitoring the NEXT step,
         * even when steps arrive faster than a new A-B-A can complete. */
        c07_real_t accepted_conductance=m->local_conductance;
        c07_mppt_invalidate(s,true);
        m->local_conductance=accepted_conductance;m->gradient_valid=true;
        m->elapsed_us=0;return;
    }
    if(c->MPPT_METHOD==2&&!m->probe_active&&!m->elapsed_us)
        m->fast_probe=a->clock_us<s->mppt_fast_until_us;
    m->elapsed_us=add_time(m->elapsed_us,dt_us);
    /* Bounded timed windows replace an indefinitely repeated settle test.
     * Normal probes include post-command blanking; abrupt-change recovery
     * uses faster continuous windows of actual V/I, without blanking.
     * Actual limit/epoch changes still invalidate outstanding work. */
    (void)settled;
    /* Result is consumed only at fast-end, after this frame's PI and limits.
     * Main cannot run while this IRQ checks/copies the committed result. */
    uint32_t ready=atomic_load_explicit(&a->result_seq,memory_order_acquire);
    if(ready&&!(ready&1u)&&ready!=a->consumed_result){
        a->consumed_result=ready;
        const volatile c07_mppt_result *r=&a->result;
        bool fresh=a->pending&&ready==a->pending_request&&r->job.epoch==a->epoch
            &&r->job.captured_us<=a->clock_us&&a->clock_us-r->job.captured_us<=c->MPPT_PERIOD_US;
        if(fresh&&r->valid&&r->job.state.target>=minimum&&r->job.state.target<=m->maximum){
            *m=r->job.state;clear_window(m);m->elapsed_us=0;
            a->pending=false;a->applied++;a->epoch++;
            return;
        }
        a->rejected++;
        if(a->pending&&ready==a->pending_request&&r->job.epoch==a->epoch){
            c07_mppt_invalidate(s,true);m->elapsed_us=0;return;
        }
    }
    if(a->pending){
        if(a->clock_us-a->pending_since_us<=c->MPPT_PERIOD_US)return;
        a->expired++;c07_mppt_invalidate(s,true);m->elapsed_us=0;return;
    }
    m->settled_us=add_time(m->settled_us,dt_us);
    if((c->MPPT_METHOD!=2||!m->fast_probe)&&m->settled_us<c->MPPT_SETTLE_US)return;
    m->voltage_sum+=voltage*R(dt_us);m->current_sum+=current*R(dt_us);
    m->window_us=add_time(m->window_us,dt_us);
    /* The complete three-point decision takes at least MPPT_PERIOD_US.
     * Ipv is upstream of Cin, so use actual paired PV V/I during the local
     * voltage transient rather than pretending the command was achieved. */
    uint32_t period=c->MPPT_PERIOD_US;
    if(c->MPPT_METHOD==2){
        if(m->fast_probe)period=(c->MPPT_PERIOD_US+2u)/3u;
        else {
            if(m->probe_active)period=add_time(c->MPPT_SETTLE_US,c->MPPT_WINDOW_US);
            if(m->probe_observation_us>period)period=m->probe_observation_us;
        }
    }
    if(m->elapsed_us<period||m->window_us<c->MPPT_WINDOW_US)return;
    uint32_t id=a->next_request+2u;if(!id)id=2u;a->next_request=id;
    atomic_store_explicit(&a->request_seq,id-1u,memory_order_relaxed);
    atomic_thread_fence(memory_order_release);
    a->request=(c07_mppt_job){.epoch=a->epoch,.captured_us=a->clock_us,.request_id=id,.minimum=minimum,.state=*m};
    atomic_store_explicit(&a->request_seq,id,memory_order_release);
    a->pending=true;a->pending_request=id;a->pending_since_us=a->clock_us;a->published++;
}

void c07_config_defaults(c07_config *c){
    if(!c)return;
    c->MPPT_METHOD=0;c->MPPT_STEP_MODE=1;
#define C07_DEFAULT_REAL(name,value) c->name=R(value);
    C07_CONFIG_REAL_FIELDS(C07_DEFAULT_REAL)
#undef C07_DEFAULT_REAL
#define C07_DEFAULT_TIME(name,value) c->name=(uint32_t)(value);
    C07_CONFIG_TIME_FIELDS(C07_DEFAULT_TIME)
#undef C07_DEFAULT_TIME
}
static bool valid_config(const c07_config *c){
#define C07_FINITE(name,value) if(!isfinite(c->name))return false;
    C07_CONFIG_REAL_FIELDS(C07_FINITE)
#undef C07_FINITE
    return c->MPPT_METHOD<=2 && c->MPPT_STEP_MODE<=2
      && c->MPPT_VOLTAGE_DEADBAND_V>=R(0) && c->MPPT_CURRENT_DEADBAND_A>=R(0)
      && c->MPPT_SLOPE_CURRENT_FLOOR_A>R(0)
      && c->MPPT_JUMP_CURRENT_FRACTION>R(0)&&c->MPPT_JUMP_CURRENT_FRACTION<R(1)
      && c->POWER_DEADBAND_W>=R(0) && c->MPPT_STEP_GAIN_V>=R(0)
      && c->MPPT_MAX_HOLD_US>0 && c->MPPT_PROBE_MAX_V>=c->MPPT_STEP_MIN_V
      && c->MPPT_PROBE_MAX_V>c->MPPT_VOLTAGE_DEADBAND_V
      && c->CONTROL_PERIOD_US>0 && c->MAX_LOOP_GAP_US>=c->CONTROL_PERIOD_US
      && c->VOLTAGE_PERIOD_US>=c->CONTROL_PERIOD_US && c->MPPT_PERIOD_US>c->VOLTAGE_PERIOD_US
      && c->DUTY_MIN>R(0) && c->DUTY_MIN<c->DUTY_MAX && c->DUTY_MAX<R(1)
      && c->PV_KP_A_PER_V>=R(0) && c->PV_KI_A_PER_V_S>=R(0)
      && c->PV_KD_A_S_PER_V>=R(0) && c->IL_RISE_A_PER_S>=R(0)
      && c->PV_REFERENCE_WEIGHT>=R(0) && c->PV_REFERENCE_WEIGHT<=R(1)
      && c->IL_KP_DUTY_PER_A>=R(0) && c->IL_KI_DUTY_PER_A_S>=R(0)
      && c->CV_KP_A_PER_V>=R(0) && c->CV_KI_A_PER_V_S>=R(0)
      && c->CHARGE_CURRENT_A>R(0) && c->INPUT_FOLDBACK_BAND_V>R(0)
      && c->RAMP_CURRENT_A>R(0) && c->RAMP_COUT_MIN_F>R(0)
      && c->RAMP_MIN_TARGET_V>=R(0) && c->RAMP_MIN_TARGET_V<c->CHARGE_VOLTAGE_V
      && c->RAMP_L_MIN_H>R(0) && c->RAMP_L_MAX_H>=c->RAMP_L_MIN_H
      && c->BUCK_L_H>=c->RAMP_L_MIN_H && c->BUCK_L_H<=c->RAMP_L_MAX_H
      && c->RAMP_DIODE_VF_V>R(0) && c->RAMP_VOLTAGE_ERROR_V>=R(0)
      && c->RAMP_VOUT_LATENCY_US>0 && c->RAMP_PACKET_US>0
      && c->RAMP_PWM_PERIOD_US>0 && c->RAMP_PWM_PERIOD_US<=c->RAMP_PACKET_US
      && c->TSINK_MAX_C>c->TSINK_DERATE_C && c->MPPT_POWER_FLOOR_W>R(0)
      && c->MPPT_WINDOW_US>0 && c->MPPT_REACQUIRE_US>0
      && c->MPPT_STEP_MIN_V>R(0) && c->MPPT_STEP_MAX_V>=c->MPPT_STEP_MIN_V
      && c->MPPT_INITIAL_FRACTION>R(0) && c->MPPT_INITIAL_FRACTION<R(1);
}
int c07_init(c07_controller *s,const c07_config *c){
    if(!s || !c)return C07_ERR_ARGUMENT;
    memset(s,0,sizeof(*s));
    if(!valid_config(c))return C07_ERR_CONFIG;
    atomic_init(&s->async.request_seq,0);atomic_init(&s->async.result_seq,0);
    s->cfg=*c;
    s->pulse_area_factor=R(c->RAMP_PWM_PERIOD_US)/(R(2000000)*c->BUCK_L_H);
    /* Immutable configuration: precompute the original expressions for
     * nominal and adjacent timer ticks. Other measured intervals retain
     * the original arithmetic. Neither dt nor filter response is changed. */
    for(unsigned k=0;k<3;k++){
        uint32_t period=c->CONTROL_PERIOD_US;
        if(k==1&&period>1)period--;
        if(k==2&&period<UINT32_MAX)period++;
        c07_real_t t=R(period);
        s->period_dt_s[k]=t/R(1000000);
        s->period_il_alpha[k]=t/(R(c->IL_FILTER_US)+t);
        s->period_voltage_alpha[k]=t/(R(c->VOLTAGE_FILTER_US)+t);
        s->period_derivative_alpha[k]=t/(R(c->PV_D_FILTER_US)+t);
    }
    s->pv_pi.kp=c->PV_KP_A_PER_V;s->pv_pi.ki=c->PV_KI_A_PER_V_S;
    s->current_pi.kp=c->IL_KP_DUTY_PER_A;s->current_pi.ki=c->IL_KI_DUTY_PER_A_S;
    s->cv_pi.kp=c->CV_KP_A_PER_V;s->cv_pi.ki=c->CV_KI_A_PER_V_S;
    c07_reset(s);return C07_OK;
}
void c07_reset(c07_controller *s){
    if(!s)return;
    c07_mppt_invalidate(s,true);
    s->duty=R(0);s->ramp_applied_duty=R(0);s->current_target=R(0);s->initialized=false;s->tracking_started=false;
    s->current=R(0);s->current_feedback=R(0);s->dcm_current_floor=R(0);
    s->guard_previous_valid=false;s->guard_tracked=false;s->guard_remaining_us=0;
    s->mppt_raw_valid=false;s->mppt_discontinuities=0;s->mppt_fast_until_us=0;
    s->output_voltage=R(0);s->pv_voltage=R(0);s->power=R(0);
    s->pv_previous=R(0);s->pv_derivative=R(0);
    s->outer_elapsed_us=0;s->cv_ceiling=s->cfg.CHARGE_CURRENT_A;
    s->limited=true;s->limit_reason=C07_LIMIT_STOPPED;
    s->reacquire_elapsed_us=0;s->reacquisitions=0;s->restart_feedforward_pending=false;s->off_current_hold=false;
    s->reacquire_il_sum=R(0);s->reacquire_ipv_sum=R(0);
    pi_track(&s->pv_pi,R(0),R(0),R(0));pi_track(&s->current_pi,R(0),R(0),R(0));
    pi_track(&s->cv_pi,s->cfg.CHARGE_CURRENT_A,R(0),R(0));mppt_reset(s,R(0),R(0));
}
int c07_start_tracking(c07_controller *s,c07_real_t voc,c07_real_t battery){
    if(!s)return C07_ERR_ARGUMENT;
    if(!isfinite(voc)||!isfinite(battery)){c07_reset(s);return C07_ERR_SAMPLE;}
    const c07_config *c=&s->cfg;
    c07_real_t minimum=hi(battery+c->PV_HEADROOM_V,(battery+c->BUCK_LOSS_MARGIN_V)/c->DUTY_MAX);
    c07_mppt_invalidate(s,true);
    mppt_reset(s,voc,minimum);s->tracking_started=false;s->outer_elapsed_us=0;return C07_OK;
}
static c07_real_t ramp(c07_controller *s,const c07_sample *i,uint32_t us){
    const c07_config *c=&s->cfg;
    /* LTC4364 UV divider: 243k/(2.74k+4.99k), all 0.1% TNPW parts.
     * At the selected IC threshold envelope the UV rising bound is 44.199V
     * (falling 41.599V). A 42V battery must not cap startup at only 42.5V.
     * 44.5V leaves room for the declared voltage/RC allowance while the IC
     * starts; once it conducts, the battery clamps Vout below this ceiling. */
    c07_real_t target=lo(hi(i->vbat+c->CONNECT_OFFSET_V,c->RAMP_MIN_TARGET_V),
                         lo(c->CHARGE_VOLTAGE_V,c->VOUT_TRIP_V-R(.5)));
    s->limited=true;s->limit_reason=C07_LIMIT_STARTUP;
    /* Startup is diode-emulation, not a voltage PI loop. Do not add the
     * charging loop's 1ms voltage filter to the physical 323us sensor RC.
     * A DCM current sample may read zero while every pulse still charges Cout.
     * Estimate that triangular charge from the previous actual duty too.
     * C07 nominal Cout=960uF and L=200uH. 768uF/150..250uH are declared model
     * design corners, not commissioned all-temperature component guarantees.
     * 1000us observation allowance covers the nominal 323us RC plus the 601us
     * frame/compute deadline. 800us covers lease plus commutation calculation.
     * Board commissioning must validate these model/design assumptions. */
    c07_real_t vo=hi(i->vout,R(0)),vin=hi(i->vin,R(1));
    c07_real_t delta=hi(vin-vo,R(0));
    c07_real_t period=R(c->RAMP_PWM_PERIOD_US)/R(1000000);
    c07_real_t prior=s->ramp_applied_duty;
    c07_real_t ripple=delta*prior*period/c->RAMP_L_MIN_H;
    c07_real_t sensed=hi(i->il,R(0));
    c07_real_t peak=sensed+ripple;
    c07_real_t demag=c->RAMP_L_MAX_H*ripple/hi(vo+c->RAMP_DIODE_VF_V,R(.1));
    c07_real_t dcm_average=R(.5)*ripple*lo(R(1),prior+demag/period);
    c07_real_t mean=hi(sensed,dcm_average);
    c07_real_t observed=vo+c->RAMP_VOLTAGE_ERROR_V
        +mean*R(c->RAMP_VOUT_LATENCY_US)/R(1000000)/c->RAMP_COUT_MIN_F;
    /* With both gates OFF, stored positive L energy can still raise Cout. */
    c07_real_t coast=(c07_real_t)sqrt((double)(observed*observed
        +c->RAMP_L_MAX_H*peak*peak/c->RAMP_COUT_MIN_F));
    c07_real_t remaining=hi(target-coast,R(0));
    c07_real_t packet=hi(R(c->RAMP_PACKET_US),R(us))/R(1000000);
    s->current_target=lo(c->RAMP_CURRENT_A,c->RAMP_COUT_MIN_F*remaining/(R(2)*packet));
    if(remaining<=R(0)||s->current_target<=c->ZERO_CURRENT_TARGET_A){
        s->duty=R(0);s->ramp_applied_duty=R(0);return R(0);
    }
    /* This DCM duty ceiling comes from the triangular pulse area:
     * Iavg = (Vin-Vo)(Vin+Vf) D^2 T / [2 L (Vo+Vf)].
     * At very low Vo the hardware's 3% minimum exceeds that average-current
     * request; sampled-current inhibition makes finite startup bursts there.
     * 0.5 A is a startup target, not an instantaneous current guarantee. */
    c07_real_t cap=(c07_real_t)sqrt((double)(R(2)*s->current_target*c->RAMP_L_MIN_H
        *(vo+c->RAMP_DIODE_VF_V)/(period*hi(delta,R(.1))*(vin+c->RAMP_DIODE_VF_V))));
    cap=clamp(cap,c->DUTY_MIN,c->DUTY_MAX);
    c07_real_t ei=sensed-s->current_target;
    if(ei>R(0))s->duty-=ei*c->CURRENT_REDUCTION_PER_A_S*R(us)/R(1000000);
    else if(ei<R(0))
        s->duty+=c->DUTY_RISE_PER_S*R(us)/R(1000000);
    s->duty=clamp(s->duty,R(0),cap);
    s->ramp_applied_duty=(sensed>s->current_target+c->CURRENT_DEADBAND_A
        ||s->duty<c->DUTY_MIN)?R(0):s->duty;
    return s->ramp_applied_duty;
}
/* Triangle-area feedforward in DCM, Vo/Vin in CCM. The nominal C07 L is
 * a controller parameter, not a replacement for raw-current protection.
 * At the selected feedforward crossover the expressions agree continuously. */
static c07_real_t current_feedforward(c07_real_t ff,c07_real_t area,c07_real_t target){
    if(area<=R(0))return ff;
    if(target<=R(0))return R(0);
    if(target>=area*ff*ff)return ff;
    return _Generic((c07_real_t)0,float:sqrtf,default:sqrt)(target/area);
}
static c07_real_t charge(c07_controller *s,const c07_sample *i,uint32_t us){
    const c07_config *c=&s->cfg;
    unsigned slot=period_slot(c->CONTROL_PERIOD_US,us);
    c07_real_t dt=slot<3?s->period_dt_s[slot]:R(us)/R(1000000);
    c07_real_t minimum=hi(i->vbat+c->PV_HEADROOM_V,
                         (hi(i->vout,i->vbat)+c->BUCK_LOSS_MARGIN_V)/c->DUTY_MAX);
    c07_real_t ff_ccm=clamp(i->vout/hi(i->vin,R(1)),R(0),c->DUTY_MAX),area=R(0);
    /* One shared pulse-area coefficient for both observation and FF.
     * Confirmed OFF may use FF; unknown metadata may not. */
    if(!i->applied_synchronous&&(i->applied_pwm_valid||i->applied_pwm_known_off)
       &&i->vin>i->vout&&i->vout>=R(0))
        area=(i->vin-i->vout)*(i->vin+c->RAMP_DIODE_VF_V)*s->pulse_area_factor/
                                       (i->vout+c->RAMP_DIODE_VF_V);
    /* A late ADC sample in diode-emulation can read zero despite positive
     * pulse charge. Use a model floor only for an actually applied DCM plan;
     * larger sensed current always wins. Sensor diagnostics retain raw il. */
    s->dcm_current_floor=R(0);s->current_feedback=s->current;
    if(i->applied_pwm_valid&&area>R(0)&&i->applied_duty>R(0)&&i->applied_duty<ff_ccm){
        s->dcm_current_floor=area*i->applied_duty*i->applied_duty;
        s->current_feedback=hi(s->current,s->dcm_current_floor);
    }
    /* A sudden raw-current drop is a suspicion, not a confirmed fault.
     * Keep ordinary raw/DCM feedback; never conceal it from diagnostics.
     * Only positive Duty movement is held for two nominal decisions. Raw
     * supervisory diagnostics keep deciding from the raw measurements.
     * The existing 1 ms voltage-response allowance bounds each hold.
     * Fixed c07 allowances match commissioning: 0.2 A per endpoint,
     * 400 ns at 50 kHz (0.02 Duty), Vin 0.03 V, Vout 0.02 V,
     * and one 12-bit ADC voltage code. No new hard 15 A trip.
     * A confirmed return to the pre-drop current can undo the cap's PI bias
     * during the hold/expiry frame, never on persistent-low expiry alone. */
    bool guard_was_active=s->guard_remaining_us>0;
    if(s->guard_remaining_us>us)s->guard_remaining_us-=us;
    else s->guard_remaining_us=0;
    bool guard_metadata=i->applied_pwm_valid&&i->applied_duty>R(0);
    if(!guard_metadata){
        s->guard_remaining_us=0;s->guard_previous_valid=false;s->guard_tracked=false;
    }
    if(guard_metadata&&s->dcm_current_floor==R(0)&&absr(i->il)<=R(.2)
       &&s->guard_previous_valid&&!s->guard_remaining_us
       &&s->guard_prev_il-i->il>R(.4)){
        c07_real_t dh=lo(R(1),hi(i->applied_duty,s->guard_prev_duty)+R(.02));
        c07_real_t vhi=hi(i->vin,s->guard_prev_vin)+R(.03)+R(.02835360440340909);
        c07_real_t vlo=lo(i->vout,s->guard_prev_vout)-R(.02)-R(.02835360440340909);
        c07_real_t ripple=hi(R(0),vhi-vlo)*dh*R(c->RAMP_PWM_PERIOD_US)/
                           (R(1000000)*c->RAMP_L_MIN_H);
        if(s->guard_prev_il-i->il>ripple+R(.4)){
            s->guard_remaining_us=c->RAMP_VOUT_LATENCY_US;
            s->guard_held_il=s->guard_prev_il;s->guard_duty_ceiling=i->applied_duty;
            s->guard_held_target=s->current_target;
            s->guard_recovery_band=ripple+R(.4);s->guard_tracked=false;
        }
    }
    bool guard_active=guard_metadata&&s->guard_remaining_us>0;
    bool guard_capped=false;
    bool guard_recovered=false;
    if(guard_was_active&&guard_metadata&&s->guard_tracked){
        c07_real_t floor=s->guard_held_il-s->guard_recovery_band;
        guard_recovered=s->guard_prev_il<floor&&i->il>=floor;
    }
    if(guard_active){
        s->guard_duty_ceiling=lo(s->guard_duty_ceiling,i->applied_duty);
    }
    s->guard_previous_valid=guard_metadata;
    s->guard_prev_il=i->il;s->guard_prev_vin=i->vin;s->guard_prev_vout=i->vout;
    s->guard_prev_duty=i->applied_duty;
    c07_real_t ff=R(0);
    bool first_frame=!s->tracking_started;
    c07_real_t initial_target=R(0);
    c07_real_t ev=s->pv_voltage-s->mppt.target, ecv=c->CHARGE_VOLTAGE_V-hi(i->vbat,s->output_voltage);
    /* Measurement derivative: positive dV/dt asks for more current in a Buck
     * input-voltage loop. No reference derivative or setpoint kick.
     * Extra reference feedforward makes total P = Kp*(V-beta*Vref), while
     * pi_step still integrates the full error V-Vref. Back-calculation uses
     * this same extra term so saturation does not undo reference weighting. */
    c07_real_t pv_d=c->PV_KD_A_S_PER_V*s->pv_derivative
      +c->PV_KP_A_PER_V*(R(1)-c->PV_REFERENCE_WEIGHT)*s->mppt.target;
    if(!s->tracking_started){
        s->current_target=clamp(s->current_feedback,R(0),c->CHARGE_CURRENT_A);
        initial_target=s->current_target;
        ff=current_feedforward(ff_ccm,area,s->current_target);
        pi_track(&s->pv_pi,s->current_target,ev,pv_d);
        if(s->duty<c->DUTY_MIN){
            /* A cold OFF handover has no learned operating-point bias. */
            pi_track(&s->current_pi,R(0),R(0),R(0));s->off_current_hold=true;
        } else pi_track(&s->current_pi,s->duty,s->current_target-s->current_feedback,ff);
        /* Bumpless CV boundary at zero voltage error; positive error keeps
         * proportional current headroom while PV is the active selector. */
        s->cv_pi.integral=s->current_target;s->tracking_started=true;
    }
    s->outer_elapsed_us=add_time(s->outer_elapsed_us,us);s->limited=false;s->limit_reason=C07_LIMIT_MPPT;
    c07_real_t prior_target=s->current_target;
    c07_real_t ceiling=c->CHARGE_CURRENT_A;
    c07_limit ceiling_reason=C07_LIMIT_CURRENT;
    bool outer_step=s->outer_elapsed_us>=c->VOLTAGE_PERIOD_US;
    if(outer_step){
        c07_real_t odt=R(s->outer_elapsed_us)/R(1000000);s->outer_elapsed_us=0;
        s->cv_ceiling=pi_step(&s->cv_pi,ecv,odt,R(0),ceiling,R(0));
        c07_real_t wanted=pi_step(&s->pv_pi,ev,odt,R(0),s->cv_ceiling,pv_d);
        s->current_target=c->IL_RISE_A_PER_S>R(0)?lo(wanted,s->current_target+c->IL_RISE_A_PER_S*odt):wanted;
        pi_track(&s->pv_pi,s->current_target,ev,pv_d);
    }
    if(s->cv_ceiling<ceiling){ceiling=s->cv_ceiling;ceiling_reason=C07_LIMIT_CV;}
    /* 57.1 V is the CV regulation target, not the emergency OFF threshold.
     * The board supervisor independently latches the raw-voltage trip. */
    if(hi(i->vbat,i->vout)>=c->VOUT_TRIP_V){ceiling=R(0);ceiling_reason=C07_LIMIT_VOLTAGE;}
    if(i->ipv>=c->INPUT_CURRENT_LIMIT_A){
        c07_real_t cap=hi(R(0),prior_target-c->INPUT_LIMIT_REDUCTION_A_PER_S*dt);
        if(cap<ceiling){ceiling=cap;ceiling_reason=C07_LIMIT_INPUT_CURRENT;}
    }
    c07_real_t margin=i->vin-i->vbat;
    if(margin<c->PV_HEADROOM_V+c->INPUT_FOLDBACK_BAND_V){
        c07_real_t fraction=clamp((margin-c->PV_HEADROOM_V)/c->INPUT_FOLDBACK_BAND_V,R(0),R(1));
        c07_real_t cap=c->CHARGE_CURRENT_A*fraction;
        if(cap<ceiling){ceiling=cap;ceiling_reason=C07_LIMIT_INPUT_FOLDBACK;}
    }
    if(minimum>s->mppt.maximum){ceiling=R(0);ceiling_reason=C07_LIMIT_BUCK_UNREACHABLE;}
    if(i->tsink>c->TSINK_DERATE_C){
        c07_real_t fraction=clamp((c->TSINK_MAX_C-i->tsink)/(c->TSINK_MAX_C-c->TSINK_DERATE_C),R(0),R(1));
        c07_real_t cap=c->CHARGE_CURRENT_A*fraction;
        if(cap<ceiling){ceiling=cap;ceiling_reason=C07_LIMIT_THERMAL;}
    }
    if(s->current_target>=ceiling-c->CURRENT_DEADBAND_A){
        s->limited=true;s->limit_reason=ceiling_reason;
    }
    bool reduced=s->current_target>ceiling;
    if(reduced){s->current_target=hi(R(0),ceiling);pi_track(&s->pv_pi,s->current_target,ev,pv_d);}
    /* Inactive CV tracks the selected current at zero CV error. This retains
     * proportional voltage headroom instead of cancelling it each tick and
     * accidentally imposing Ki_cv*voltage_error as a normal-current slew.
     * An active CV PI keeps its own integral; a separate safety selector can
     * still back-calculate it when that selector reduces the current further. */
    if(outer_step||reduced){
        if(s->current_target<s->cv_ceiling-R(1e-6))s->cv_pi.integral=s->current_target;
        else if(reduced)pi_track(&s->cv_pi,s->current_target,ecv,R(0));
    }
    c07_real_t ei=s->current_target-s->current_feedback;
    if(!first_frame||s->current_target!=initial_target)
        ff=current_feedforward(ff_ccm,area,s->current_target);
    if(s->current_target<=c->ZERO_CURRENT_TARGET_A){
        /* OFF is outside the continuous control range: hold the learned
         * integral rather than forcing a -feedforward bias. In light-load
         * DCM, that learned bias is needed on the next positive request. */
        s->duty=R(0);s->off_current_hold=true;
    }
    else if((s->off_current_hold||s->restart_feedforward_pending) &&
            s->current>hi(c->MPPT_NOLOAD_A,s->current_target+c->CURRENT_DEADBAND_A)){
        /* Let residual L1 energy decay before resuming a smaller current. */
        s->duty=R(0);
        s->limited=true;s->limit_reason=C07_LIMIT_CURRENT;
    }
    else {
        s->off_current_hold=false;
        if(s->restart_feedforward_pending){pi_track(&s->current_pi,R(0),R(0),R(0));s->restart_feedforward_pending=false;}
        if(guard_recovered){
            /* Recover only after the raw signal returns. Preserve negative
             * proportional movement from lower Iref or above-pre-drop IL. */
            c07_real_t recovered_duty=lo(i->applied_duty,i->applied_duty+
                s->current_pi.kp*(s->current_target-s->guard_held_target+
                                 s->guard_held_il-s->current_feedback));
            recovered_duty=clamp(recovered_duty,R(0),c->DUTY_MAX);
            pi_track(&s->current_pi,recovered_duty,ei,ff);
            s->guard_tracked=false;
        }
        s->duty=pi_step(&s->current_pi,ei,dt,R(0),c->DUTY_MAX,ff);
        if(guard_active&&s->duty>s->guard_duty_ceiling){
            s->duty=s->guard_duty_ceiling;
            pi_track(&s->current_pi,s->duty,ei,ff);
            s->guard_tracked=true;guard_capped=true;
        }
        if(s->duty>R(0) && s->duty<c->DUTY_MIN){s->duty=R(0);s->limited=true;s->limit_reason=C07_LIMIT_MIN_DUTY;}
        else if(s->duty>=c->DUTY_MAX){
            s->limited=true;s->limit_reason=C07_LIMIT_MAX_DUTY;
            pi_track(&s->pv_pi,lo(s->current_target,hi(R(0),s->current_feedback)),ev,pv_d);
        }
    }
    if(guard_capped){s->limited=true;s->limit_reason=C07_LIMIT_CURRENT;}
    bool pair_ok=i->pv_pair_span_us>=0 && (uint32_t)i->pv_pair_span_us<=c->MPPT_MAX_PAIR_SPAN_US;
    /* Evaluate the sustained base target, not the temporary probe B.
     * Tiny probe-induced pulses must not cancel an otherwise unloaded,
     * unreachable-voltage observation window on every local comparison. */
    c07_real_t base_target=s->mppt.probe_active?s->mppt.probe_center_v:s->mppt.target;
    bool reacquire=pair_ok && s->pv_voltage<base_target-c->MPPT_SETTLE_V && i->vin>minimum
      && (s->limit_reason==C07_LIMIT_MPPT || s->limit_reason==C07_LIMIT_MIN_DUTY);
    if(reacquire){
        s->reacquire_elapsed_us=add_time(s->reacquire_elapsed_us,us);
        s->reacquire_il_sum+=absr(i->il)*R(us);
        s->reacquire_ipv_sum+=absr(i->ipv)*R(us);
    }else{
        s->reacquire_elapsed_us=0;s->reacquire_il_sum=R(0);s->reacquire_ipv_sum=R(0);
    }
    bool no_extraction=s->reacquire_elapsed_us>=c->MPPT_REACQUIRE_US
        &&s->reacquire_il_sum<c->MPPT_NOLOAD_A*R(s->reacquire_elapsed_us)
        &&s->reacquire_ipv_sum<c->MPPT_NOLOAD_A*R(s->reacquire_elapsed_us);
    if(no_extraction){
        c07_mppt_invalidate(s,true);
        mppt_reset(s,i->vpv,minimum);
        s->mppt.target=clamp(i->vpv-c->MPPT_STEP_MAX_V,minimum,s->mppt.maximum);
        ev=s->pv_voltage-s->mppt.target;
        pv_d=c->PV_KD_A_S_PER_V*s->pv_derivative
          +c->PV_KP_A_PER_V*(R(1)-c->PV_REFERENCE_WEIGHT)*s->mppt.target;
        pi_track(&s->pv_pi,R(0),ev,pv_d);pi_track(&s->current_pi,R(0),R(0),R(0));
        s->restart_feedforward_pending=true;s->reacquisitions++;
    }
    if(s->reacquire_elapsed_us>=c->MPPT_REACQUIRE_US){
        s->reacquire_elapsed_us=0;s->reacquire_il_sum=R(0);s->reacquire_ipv_sum=R(0);
    }
    /* A DCM point-current mismatch is not a voltage-window quality test. */
    bool settled=absr(ev)<=c->MPPT_SETTLE_V;
    if(c->MPPT_METHOD==0)mppt_update_legacy(s,s->pv_voltage,s->power,minimum,us,s->limited||!pair_ok,settled);
    else mppt_update_selection(s,i->vpv,i->ipv,minimum,us,s->limited||!pair_ok,settled);
    return s->duty;
}
int c07_step(c07_controller *s,const c07_sample *i,uint32_t us,bool charging,c07_real_t *out){
    if(out)*out=R(0);
    if(!s||!i||!out)return C07_ERR_ARGUMENT;
    s->async.clock_us+=us;
    if(!charging)c07_mppt_invalidate(s,true);
    if(!us||us>s->cfg.MAX_LOOP_GAP_US){c07_reset(s);return C07_ERR_DT;}
    if(!i->valid||!isfinite(i->il)||!isfinite(i->ipv)||!isfinite(i->vpv)||!isfinite(i->vin)
       ||!isfinite(i->vout)||!isfinite(i->vbat)||!isfinite(i->tsink)
       ||(i->applied_pwm_valid&&(!isfinite(i->applied_duty)||i->applied_duty<R(0)||i->applied_duty>R(1)))){
        c07_reset(s);return C07_ERR_SAMPLE;
    }
    unsigned slot=period_slot(s->cfg.CONTROL_PERIOD_US,us);
    c07_real_t ai=!s->initialized||s->cfg.IL_FILTER_US==0?R(1):
        (slot<3?s->period_il_alpha[slot]:R(us)/(R(s->cfg.IL_FILTER_US)+R(us)));
    c07_real_t av=s->initialized?(slot<3?s->period_voltage_alpha[slot]:
        R(us)/(R(s->cfg.VOLTAGE_FILTER_US)+R(us))):R(1);
    s->current+=ai*(i->il-s->current);s->output_voltage+=av*(i->vout-s->output_voltage);
    s->pv_voltage+=av*(i->vpv-s->pv_voltage);s->power=i->vpv*i->ipv;
    if(s->initialized){
        c07_real_t raw=(s->pv_voltage-s->pv_previous)*R(1000000)/R(us);
        c07_real_t ad=slot<3?s->period_derivative_alpha[slot]:
            R(us)/(R(s->cfg.PV_D_FILTER_US)+R(us));
        s->pv_derivative+=ad*(raw-s->pv_derivative);
    }else s->pv_derivative=R(0);
    s->pv_previous=s->pv_voltage;s->initialized=true;
    if(!isfinite(s->current)||!isfinite(s->output_voltage)||!isfinite(s->pv_voltage)||!isfinite(s->power)
       ||!isfinite(s->pv_derivative)||!isfinite(s->pv_previous)){
        c07_reset(s);return C07_ERR_NUMERIC;
    }
    c07_real_t duty=charging?charge(s,i,us):ramp(s,i,us);
    if(!isfinite(duty)||!isfinite(s->current_target)||!isfinite(s->pv_pi.integral)
       ||!isfinite(s->current_pi.integral)||!isfinite(s->cv_pi.integral)
       ||!isfinite(s->mppt.target)||!isfinite(s->mppt.power_sum)||!isfinite(s->mppt.voltage_sum)){
        c07_reset(s);return C07_ERR_NUMERIC;
    }
    *out=duty;return C07_OK;
}
const char *c07_limit_name(c07_limit r){
    static const char *const names[]={"STOPPED","STARTUP","MPPT","CV","VOLTAGE_LIMIT",
      "INPUT_CURRENT","INPUT_FOLDBACK","BUCK_UNREACHABLE","THERMAL","CURRENT_LIMIT","MIN_DUTY","MAX_DUTY"};
    return (unsigned)r<sizeof(names)/sizeof(names[0])?names[r]:"UNKNOWN";
}
