MahleCube/solar-circuit/firmware/r04/src/startup.c

#include "startup.h"
#include "board_config.h"
#include "commissioning.h"
#include <math.h>
#include <string.h>

/* Sample/config finiteness is validated before these comparisons. Avoid the
 * general libm NaN/signed-zero paths in the software-double IRQ hot path. */
static inline c07_real_t larger(c07_real_t a,c07_real_t b){return a>b?a:b;}
static inline c07_real_t smaller(c07_real_t a,c07_real_t b){return a<b?a:b;}
static void clear_command(c07_command *c) {
    c->bias_enable=c->pv_enable=c->battery_enable=c->pv_rearm=c->synchronous_allowed=false;
    c->duty=0;
}
static void enter(c07_charger *c, c07_state state, uint64_t now) {
    c->state=state; c->entered_us=now; c->stable_valid=false;
    if (state!=C07_CHARGING) {
        c->feedback_window_valid=false;
        c->input_feedback_window_valid=false;
    }
    if (state==C07_PV_CONNECT) { c->rearm_started=false; c->rearm_finished=false; }
}
static bool stable(c07_charger *c, bool condition, uint64_t now, uint32_t duration) {
    if (!condition) { c->stable_valid=false; return false; }
    if (!c->stable_valid) { c->stable_valid=true; c->stable_since_us=now; }
    return now-c->stable_since_us>=duration;
}
static bool connected_voltage_stable(const c07_sample *s){
    /* BAT_EN permits the LTC4364, not forced closure of a bilateral switch.
     * Its ideal diode blocks a charged battery from an empty Cout. This is
     * an operating-path check, not a precision preconnection voltage window. */
    return fabs(s->vout-s->vbat)<=C07_RUN_DELTA_V;
}
static bool input_available(const c07_sample *s){
    /* Also check residual Cin: battery headroom alone cannot exclude a
     * panel below the disconnected input capacitor. */
    return s->vpv>s->vbat+C07_HEADROOM_V+C07_INPUT_RESTART_MARGIN_V
        &&s->vpv>s->vin+C07_PV_CONNECT_MARGIN_V;
}
static bool switching_state(c07_state state) {
    return state==C07_RAMP_OUTPUT||state==C07_CONNECT_BATTERY||state==C07_CHARGING;
}
static bool powered_state(c07_state state) {
    return state==C07_BIAS||switching_state(state)||state==C07_STOPPING||state==C07_CHARGE_HOLD;
}
static bool cv_pause(const c07_charger *c,const c07_sample *s) {
    const c07_controller *r=&c->regulator;
    /* A zero request by itself is not evidence of a full battery. Require the
     * actual CV cap and terminal voltage, not the last-written display reason.
     * Wait for residual current before declaring the charge path inactive. */
    return r->cv_ceiling<=r->cfg.ZERO_CURRENT_TARGET_A
        &&r->current_target<=r->cfg.ZERO_CURRENT_TARGET_A&&r->duty==0
        &&s->vbat>=r->cfg.CHARGE_VOLTAGE_V-r->cfg.VOLTAGE_DEADBAND_V
        &&fabs(s->il)<=C07_STOP_CURRENT_A;
}
static void feedback_start(c07_charger *c,const c07_sample *s,c07_real_t duty) {
    c->feedback_window_valid=true;c->feedback_window_us=0;
    c->feedback_interval_count=0;c->feedback_interval_next=0;
    c->feedback_start_vin=c->feedback_prev_vin=s->vin;
    c->feedback_prev_vout=s->vout;c->feedback_prev_ipv=s->ipv;c->feedback_prev_duty=duty;
    c->feedback_input_charge=c->feedback_dcm_charge=c->feedback_volt_seconds=0;
    c->feedback_max_ripple=0;
}
static const char *feedback_fault(c07_charger *c,const c07_sample *s,
                                  uint32_t dt) {
    const c07_config *cfg=&c->regulator.cfg;
    const c07_commutation_config *p=&c07_commissioning.commutation;
    /* ADC IL is phase sampled through a 10 us analog filter. A zero sample in
     * DCM is legitimate. Only a complete low-current window with contradictory
     * voltage/current response is diagnosed. Missing PWM confirmation is not
     * interpreted as an applied command. OFF needs explicit board confirmation. */
    if(c->state!=C07_CHARGING||fabs(s->il)>p->current_error_a
       ||(!s->applied_pwm_valid&&!s->applied_pwm_known_off)) {
        c->feedback_window_valid=false;return NULL;
    }
    c07_real_t duty=s->applied_pwm_valid?s->applied_duty:0;
    if(!isfinite(duty)||duty<0||duty>C07_DUTY_MAX) {
        c->feedback_window_valid=false;return NULL;
    }
    if(!c->feedback_window_valid) {
        if(duty>0)feedback_start(c,s,duty);
        return NULL;
    }
    /* The usual integer period needs no soft-double conversion/multiply.
     * Retain the measured dt for every non-nominal interval. Combine immutable
     * voltage allowances before applying them to the measured endpoint. */
    const c07_real_t seconds=dt==C07_LOOP_US
        ?(c07_real_t)C07_LOOP_US*1e-6:(c07_real_t)dt*1e-6;
    const c07_real_t vin_error=p->vin_error_v+C07_VOLTAGE_LSB_V;
    const c07_real_t vo_error=p->vout_error_v+C07_VOLTAGE_LSB_V;
    c07_real_t vin_hi=larger(s->vin,c->feedback_prev_vin)+vin_error;
    c07_real_t vin_lo=larger(0,smaller(s->vin,c->feedback_prev_vin)-vin_error);
    c07_real_t vo_hi=larger(s->vout,c->feedback_prev_vout)+vo_error;
    c07_real_t vo_lo=larger(0,smaller(s->vout,c->feedback_prev_vout)-vo_error);
    c07_real_t d_hi=smaller(1,larger(duty,c->feedback_prev_duty)+p->hs_off_max_s*C07_PWM_HZ);
    c07_real_t d_lo=larger(0,smaller(duty,c->feedback_prev_duty)-p->hs_on_max_s*C07_PWM_HZ);
    /* Full peak ripple, not half-ripple or D*sampleIL: this is an upper envelope
     * for a zero-trough DCM waveform, using the existing minimum-L corner. */
    c07_real_t ripple=larger(0,vin_hi-vo_lo)*d_hi*c->feedback_ripple_per_v_duty;
    c07_feedback_interval *part=&c->feedback_intervals[c->feedback_interval_next];
    part->start_vin=c->feedback_prev_vin;part->dt_us=dt;part->ripple=ripple;
    part->input_charge=smaller(larger(0,s->ipv),larger(0,c->feedback_prev_ipv))*seconds;
    part->upper_charge=d_hi*(2*p->current_error_a+ripple)*seconds;
    /* A second witness also covers an unresponsive driver/current feedback.
     * Diode conduction and the existing loss allowance reduce this estimate.
     * Signed integration prevents a negative-drive interval counting as proof. */
    /* Same signed volt-seconds: D*Vin-Vo-(1-D)*Vf-loss, factored to remove
     * a runtime multiplication and reuse the init-owned Vf+loss constant. */
    c07_real_t drive=d_lo*(vin_lo+cfg->RAMP_DIODE_VF_V)-vo_hi-c->feedback_diode_loss_v;
    part->volt_seconds=drive*seconds;
    if(++c->feedback_interval_next==3)c->feedback_interval_next=0;
    if(c->feedback_interval_count<3)c->feedback_interval_count++;
    /* Re-sum bounded intervals, rather than carrying an indefinite integral
     * or retaining a discarded ripple maximum. No extra division/multiply. */
    const c07_feedback_interval *a=&c->feedback_intervals[0];
    c->feedback_input_charge=a->input_charge;c->feedback_dcm_charge=a->upper_charge;
    c->feedback_volt_seconds=a->volt_seconds;c->feedback_max_ripple=a->ripple;
    c->feedback_window_us=a->dt_us;
    for(unsigned n=1;n<c->feedback_interval_count;n++){
        const c07_feedback_interval *b=&c->feedback_intervals[n];
        c->feedback_input_charge+=b->input_charge;c->feedback_dcm_charge+=b->upper_charge;
        c->feedback_volt_seconds+=b->volt_seconds;
        c->feedback_max_ripple=larger(c->feedback_max_ripple,b->ripple);
        c->feedback_window_us+=b->dt_us;
    }
    unsigned oldest=c->feedback_interval_count==3?c->feedback_interval_next:0;
    c->feedback_start_vin=c->feedback_intervals[oldest].start_vin;
    c->feedback_prev_vin=s->vin;c->feedback_prev_vout=s->vout;
    c->feedback_prev_ipv=s->ipv;c->feedback_prev_duty=duty;
    /* Existing 1 ms voltage-response allowance covers the 323 us voltage RC;
     * add a complete control interval for sequential ADC/command phase skew.
     * With 601 us control this evaluates after 3 intervals (1.803 ms). */
    if(c->feedback_window_us<cfg->RAMP_VOUT_LATENCY_US+C07_LOOP_US)return NULL;
    c07_real_t elapsed=c->feedback_window_us==3*C07_LOOP_US
        ?(c07_real_t)(3*C07_LOOP_US)*1e-6:(c07_real_t)c->feedback_window_us*1e-6;
    c07_real_t voltage_uncertainty=2*vin_error;
    bool input_witness=s->vin<c->feedback_start_vin-voltage_uncertainty
        &&c->feedback_input_charge>c->feedback_dcm_charge
          +(2*p->current_error_a+vin_hi*(2.0/153300.0))*elapsed;
    bool drive_witness=c->feedback_volt_seconds>
        cfg->RAMP_L_MAX_H*(2*p->current_error_a+c->feedback_max_ripple);
    if(input_witness||drive_witness)return "CURRENT_FEEDBACK_RESPONSE";
    /* Keep the same mature observation length and evaluate on every frame.
     * Known OFF may complete the existing window; it cannot start another. */
    if(duty<=0)c->feedback_window_valid=false;
    return NULL;
}
static void input_feedback_start(c07_charger *c,const c07_sample *s,
                                 c07_real_t duty) {
    c->input_feedback_window_valid=true;c->input_feedback_window_us=0;
    c->input_feedback_interval_count=0;c->input_feedback_interval_next=0;
    c->input_feedback_start_vin=c->input_feedback_prev_vin=s->vin;
    c->input_feedback_prev_vout=s->vout;c->input_feedback_prev_ipv=s->ipv;
    c->input_feedback_prev_il=s->il;c->input_feedback_prev_duty=duty;
    c->input_feedback_charge=c->input_feedback_upper_charge=0;
}
static const char *input_feedback_fault(c07_charger *c,const c07_sample *s,
                                        uint32_t dt) {
    const c07_commutation_config *p=&c07_commissioning.commutation;
    /* Keep the near-zero response and signed-drive test independent. A low
     * current sample is valid in DCM; it resets only this nonzero window.
     * Missing PWM confirmation must not be treated as an applied command. */
    if(c->state!=C07_CHARGING||fabs(s->il)<=p->current_error_a
       ||(!s->applied_pwm_valid&&!s->applied_pwm_known_off)) {
        c->input_feedback_window_valid=false;return NULL;
    }
    c07_real_t duty=s->applied_pwm_valid?s->applied_duty:0;
    if(!isfinite(duty)||duty<0||duty>C07_DUTY_MAX) {
        c->input_feedback_window_valid=false;return NULL;
    }
    if(!c->input_feedback_window_valid) {
        if(duty>0)input_feedback_start(c,s,duty);
        return NULL;
    }
    const c07_real_t seconds=dt==C07_LOOP_US
        ?(c07_real_t)C07_LOOP_US*1e-6:(c07_real_t)dt*1e-6;
    const c07_real_t vin_error=p->vin_error_v+C07_VOLTAGE_LSB_V;
    const c07_real_t vo_error=p->vout_error_v+C07_VOLTAGE_LSB_V;
    c07_real_t vin_hi=larger(s->vin,c->input_feedback_prev_vin)+vin_error;
    c07_real_t vo_lo=larger(0,smaller(s->vout,c->input_feedback_prev_vout)-vo_error);
    c07_real_t d_hi=smaller(1,larger(duty,c->input_feedback_prev_duty)
                           +p->hs_off_max_s*C07_PWM_HZ);
    c07_real_t ripple=larger(0,vin_hi-vo_lo)*d_hi*c->feedback_ripple_per_v_duty;
    /* Raw IL, not the nominal-L current-loop supplement. Add the FULL PWM
     * ripple so a phase-sampled trough is not equated with a cycle average.
     * This diagnostic uses the same voltage/current/delay envelope as the
     * near-zero monitor; unmodeled inter-sample envelope peaks and analog
     * filter history remain commissioning/model limitations. */
    c07_real_t il_upper=larger(0,larger(s->il,c->input_feedback_prev_il))
                       +2*p->current_error_a+ripple;
    c07_input_feedback_interval *part=&c->input_feedback_intervals[c->input_feedback_interval_next];
    part->start_vin=c->input_feedback_prev_vin;part->dt_us=dt;
    part->input_charge=smaller(larger(0,s->ipv),larger(0,c->input_feedback_prev_ipv))*seconds;
    part->upper_charge=d_hi*il_upper*seconds;
    if(++c->input_feedback_interval_next==3)c->input_feedback_interval_next=0;
    if(c->input_feedback_interval_count<3)c->input_feedback_interval_count++;
    const c07_input_feedback_interval *a=&c->input_feedback_intervals[0];
    c->input_feedback_charge=a->input_charge;c->input_feedback_upper_charge=a->upper_charge;
    c->input_feedback_window_us=a->dt_us;
    for(unsigned n=1;n<c->input_feedback_interval_count;n++){
        const c07_input_feedback_interval *b=&c->input_feedback_intervals[n];
        c->input_feedback_charge+=b->input_charge;c->input_feedback_upper_charge+=b->upper_charge;
        c->input_feedback_window_us+=b->dt_us;
    }
    unsigned oldest=c->input_feedback_interval_count==3?c->input_feedback_interval_next:0;
    c->input_feedback_start_vin=c->input_feedback_intervals[oldest].start_vin;
    c->input_feedback_prev_vin=s->vin;c->input_feedback_prev_vout=s->vout;
    c->input_feedback_prev_ipv=s->ipv;c->input_feedback_prev_il=s->il;
    c->input_feedback_prev_duty=duty;
    if(c->input_feedback_window_us<c->regulator.cfg.RAMP_VOUT_LATENCY_US+C07_LOOP_US)
        return NULL;
    c07_real_t elapsed=c->input_feedback_window_us==3*C07_LOOP_US
        ?(c07_real_t)(3*C07_LOOP_US)*1e-6:(c07_real_t)c->input_feedback_window_us*1e-6;
    /* Falling VIN excludes the model's ordinary Cin charging explanation.
     * Preserve two current-error allowances and both input divider loads.
     * This identifies measurement/path inconsistency, not a specific sensor
     * or a universal fault coverage claim. No nonzero signed-drive witness. */
    bool inconsistent=s->vin<c->input_feedback_start_vin-2*vin_error
        &&c->input_feedback_charge>c->input_feedback_upper_charge
          +(2*p->current_error_a+vin_hi*(2.0/153300.0))*elapsed;
    if(inconsistent)return "CURRENT_FEEDBACK_INCONSISTENCY";
    if(duty<=0)c->input_feedback_window_valid=false;
    return NULL;
}
int c07_charger_init(c07_charger *c, const c07_config *config) {
    if (!c || !config) return -1;
    memset(c,0,sizeof(*c)); c->state=C07_IDLE; c->fault="";
    int result=c07_init(&c->regulator,config);
    if(!result){
        c->feedback_ripple_per_v_duty=1.0/(C07_PWM_HZ*config->RAMP_L_MIN_H);
        c->feedback_diode_loss_v=config->RAMP_DIODE_VF_V+config->BUCK_LOSS_MARGIN_V;
    }
    return result;
}
void c07_charger_trip(c07_charger *c, const char *reason, uint64_t now) {
    if (c->state!=C07_FAULT) { c->fault=reason; enter(c,C07_FAULT,now); }
    clear_command(&c->command); c07_reset(&c->regulator);
}
void c07_charger_wait_input(c07_charger *c,uint64_t now){
    if(c->state==C07_FAULT)return;
    enter(c,C07_WAIT_INPUT,now);clear_command(&c->command);c07_reset(&c->regulator);
}
const char *c07_measurement_fault(const c07_inputs *i) {
    const c07_sample *s=&i->sample;
    if (!s->valid) return i->error ? i->error : "MEASUREMENT_INVALID";
    if (i->age_us>C07_MAX_SAMPLE_AGE_US) return "STALE_SAMPLE";
    if (!isfinite(s->vin)||!isfinite(s->vpv)||!isfinite(s->ipv)||!isfinite(s->il)
        ||!isfinite(s->vout)||!isfinite(s->vbat)||!isfinite(s->tbat)||!isfinite(s->tsink))
        return "MEASUREMENT_NONFINITE";
    if (!(s->vin>=0 && s->vin<C07_VIN_TRIP_V)) return "VIN_RANGE";
    if (!(s->vpv>=0 && s->vpv<C07_VPV_TRIP_V)) return "VPV_RANGE";
    /* Upper operating targets belong to regulation. A sample above 15 A
     * alone is not a latched fault. board.c rejects ADC rails; hardware fault
     * inputs below remain independent. Configured signed-current limits are
     * operating-envelope checks, not cycle-by-cycle current protection. */
    if (!(s->ipv>C07_REVERSE_TRIP_A)) return "IPV_RANGE";
    double il_min=c07_commissioning.commutation.enabled
        ?c07_commissioning.commutation.minimum_current_a:C07_REVERSE_TRIP_A;
    if (!(s->il>il_min)) return "IL_RANGE";
    if(c07_commissioning.commutation.enabled&&s->il>=c07_commissioning.commutation.maximum_current_a)
        return "IL_RANGE";
    if (!(s->vout>=0 && s->vout<C07_VOUT_TRIP_V)) return "VOUT_RANGE";
    /* Nominal conversion reports the ADC bin's lower edge. A physical 42V
     * sample is code 1481 = 41.9917V; retain that bin, not only code 1482.
     * This one-LSB allowance is quantization, not a general calibration waiver. */
    if (!(s->vbat+C07_VOLTAGE_LSB_V>=C07_VBAT_MIN_V && s->vbat<C07_VBAT_TRIP_V)) return "VBAT_RANGE";
    if (!(s->tbat>=C07_TBAT_MIN_C && s->tbat<C07_TBAT_MAX_C)) return "TBAT_RANGE";
    if (!(s->tsink>=-40 && s->tsink<C07_TSINK_MAX_C)) return "TSINK_RANGE";
    return NULL;
}
const c07_command *c07_charger_step(c07_charger *c, const c07_inputs *i,
                                    const c07_request *r, uint64_t now) {
    const c07_sample *s=&i->sample;
    c07_command *o=&c->command;
    clear_command(o); o->sample_us=i->sample_us;
    uint64_t dt=c->previous_valid ? now-c->previous_us : C07_LOOP_US;
    bool clock_bad=c->previous_valid && now<=c->previous_us;
    c->previous_valid=true; c->previous_us=now;
    bool reset_edge=r->reset_fault&&!c->reset_was_requested;
    c->reset_was_requested=r->reset_fault;
    const char *reason=c07_measurement_fault(i);
    if (clock_bad || dt==0 || dt>C07_MAX_LOOP_GAP_US) reason="LOOP_DEADLINE";
    if (!reason&&i->battery_fault) reason="BATTERY_FAULT";
    if (!reason&&i->pv_fault) reason="PV_OVERCURRENT";
    if(!reason&&(switching_state(c->state)||c->state==C07_CHARGE_HOLD)&&!i->bias_good)
        reason="BIAS_LOST";
    if(!reason&&i->pwm_events&&i->pwm_events!=3u)
        reason=(i->pwm_events&4u)?"PIO_LEASE_EXPIRED":"PIO_INTERLOCK";
    /* Input collapse is different from a normal current-decay stop. Disable
     * all paths and let the protection ICs enforce their reverse blocking. */
    if (c->state==C07_FAULT) {
        if (reset_edge&&!r->run&&!reason&&i->pv_stopped) { c->fault=""; enter(c,C07_IDLE,now); }
        return o;
    }
    if (reason) { c07_charger_trip(c,reason,now); return o; }
    reason=feedback_fault(c,s,(uint32_t)dt);
    if(!reason)reason=input_feedback_fault(c,s,(uint32_t)dt);
    if(reason){c07_charger_trip(c,reason,now);return o;}
    if(powered_state(c->state)
       &&(i->pv_stopped||i->pwm_events==3u)){
        c07_charger_wait_input(c,now);return o;
    }
    if((switching_state(c->state)||c->state==C07_STOPPING||c->state==C07_CHARGE_HOLD)
       &&s->vin<=larger(s->vout,s->vbat)+C07_HEADROOM_V){
        c07_charger_wait_input(c,now);return o;
    }
    if (!r->run && c->state!=C07_IDLE && c->state!=C07_STOPPING) {
        if (switching_state(c->state)||c->state==C07_CHARGE_HOLD) {
            c->stop_battery_enabled=true;
            enter(c,C07_STOPPING,now);
        } else enter(c,C07_IDLE,now);
    }
    uint64_t elapsed=now-c->entered_us;
    switch(c->state) {
    case C07_IDLE:
        c07_reset(&c->regulator);
        if (r->run && input_available(s)
            && s->vbat<C07_CHARGE_VOLTAGE_V) {
            c->open_voltage=s->vpv; enter(c,C07_CLEAR,now);
        } break;
    case C07_CLEAR:
        if (elapsed>=C07_CLEAR_US) {
            if (!i->pv_stopped) c07_charger_trip(c,"PV_CLEAR_FAILED",now);
            else if(!input_available(s))c07_charger_wait_input(c,now);
            else enter(c,C07_PV_CONNECT,now);
        } break;
    case C07_PV_CONNECT:
        if(!c->rearm_started&&!input_available(s)){
            c07_charger_wait_input(c,now);break;
        }
        if (!c->rearm_started&&elapsed>=C07_LOOP_US) { c->rearm_started=true; c->rearm_started_us=now; }
        if (c->rearm_started&&now-c->rearm_started_us>=C07_REARM_US) c->rearm_finished=true;
        if (stable(c,!i->pv_stopped&&s->vin>s->vbat+C07_HEADROOM_V&&c->rearm_finished,
                   now,C07_INPUT_STABLE_US)) enter(c,C07_BIAS,now);
        else if (elapsed>=C07_PV_TIMEOUT_US) c07_charger_wait_input(c,now);
        break;
    case C07_BIAS:
        if (stable(c,i->bias_good,now,C07_BIAS_STABLE_US)) {
            c07_reset(&c->regulator); enter(c,C07_RAMP_OUTPUT,now);
        } else if (elapsed>=C07_BIAS_TIMEOUT_US) c07_charger_trip(c,"BIAS_TIMEOUT",now);
        break;
    case C07_RAMP_OUTPUT:
        if (stable(c,connected_voltage_stable(s),now,C07_CONNECT_STABLE_US))
            enter(c,C07_CONNECT_BATTERY,now);
        else if (elapsed>=C07_RAMP_TIMEOUT_US) c07_charger_trip(c,"OUTPUT_RAMP_TIMEOUT",now);
        break;
    case C07_CONNECT_BATTERY:
        /* The UV-release ramp can temporarily exceed Vbat+1V before HGATE
         * rises. Keep its low-current/voltage cap, reset the settling window,
         * and wait for the normal IC path; do not misclassify that as a fault.
         * This settling policy is not an independent failed-IC detector. */
        if (stable(c,connected_voltage_stable(s),now,C07_BATTERY_READY_US)) {
            if (c07_start_tracking(&c->regulator,c->open_voltage,s->vbat)!=0)
                c07_charger_trip(c,"CONTROL_START",now);
            else enter(c,C07_CHARGING,now);
        } else if (elapsed>=C07_CONNECT_TIMEOUT_US) c07_charger_trip(c,"BATTERY_CONNECT_TIMEOUT",now);
        break;
    case C07_CHARGING:
        if(cv_pause(c,s)) {
            enter(c,C07_CHARGE_HOLD,now);c07_reset(&c->regulator);
        } else if (fabs(s->vout-s->vbat)>C07_RUN_DELTA_V) c07_charger_trip(c,"BATTERY_PATH_VOLTAGE",now);
        break;
    case C07_CHARGE_HOLD:
        /* A healthy unilateral path does not refill Cout from the battery.
         * Negative Vout-Vbat is expected while no charge is requested. Positive
         * mismatch/OV and every hardware fault remain monitored. */
        if(s->vout>s->vbat+C07_RUN_DELTA_V)c07_charger_trip(c,"BATTERY_PATH_VOLTAGE",now);
        else if(stable(c,s->vbat<c->regulator.cfg.CHARGE_VOLTAGE_V-2*C07_VOLTAGE_LSB_V,
                       now,C07_INPUT_STABLE_US)) {
            /* PV stayed connected: do not demand Vpv>charged Cin before a new
             * CLEAR. Requalify BIAS, then ramp/recheck Cout before charging. */
            c->open_voltage=s->vpv;enter(c,C07_BIAS,now);
        }
        break;
    case C07_STOPPING:
        if (stable(c,fabs(s->il)<=C07_STOP_CURRENT_A,now,C07_STOP_STABLE_US)) {
            enter(c,C07_IDLE,now); c07_reset(&c->regulator);
        } else if (elapsed>=C07_STOP_TIMEOUT_US) c07_charger_trip(c,"STOP_CURRENT_TIMEOUT",now);
        break;
    case C07_WAIT_INPUT:
        /* Ordinary source shortage disconnects the battery immediately.
         * Retry only after sustained open-circuit headroom, through CLEAR,
         * PV rearm, BIAS and the output ramp. Hardware faults stay latched. */
        if(stable(c,r->run&&i->pv_stopped&&input_available(s),
           now,C07_INPUT_RETRY_US)){
            c->open_voltage=s->vpv;enter(c,C07_CLEAR,now);
        }
        break;
    case C07_FAULT: break;
    }
    bool power_state=powered_state(c->state);
    bool switching=switching_state(c->state);
    if (power_state&&i->pv_stopped) { c07_charger_wait_input(c,now);return o; }
    if ((switching||c->state==C07_CHARGE_HOLD)&&!i->bias_good) c07_charger_trip(c,"BIAS_LOST",now);
    if (c->state==C07_FAULT) return o;
    o->pv_enable=c->state==C07_PV_CONNECT||power_state;
    o->pv_rearm=c->state==C07_PV_CONNECT&&c->rearm_started&&!c->rearm_finished;
    o->bias_enable=power_state;
    o->battery_enable=switching||c->state==C07_CHARGE_HOLD;
    o->synchronous_allowed=c->state==C07_CHARGING;
    if (c->state==C07_STOPPING) o->battery_enable=c->stop_battery_enabled;
    else if (switching) {
        if (c07_step(&c->regulator,s,(uint32_t)dt,c->state==C07_CHARGING,&o->duty)!=0)
            c07_charger_trip(c,"CONTROL_INVALID",now);
    }
    return o;
}
const char *c07_state_name(c07_state state) {
    static const char *names[]={"IDLE","CLEAR","PV_CONNECT","BIAS","RAMP_OUTPUT",
        "CONNECT_BATTERY","CHARGING","STOPPING","FAULT","WAIT_INPUT","CHARGE_HOLD"};
    return (unsigned)state<=(unsigned)C07_CHARGE_HOLD ? names[(unsigned)state] : "INVALID";
}
