MahleCube/solar-circuit/firmware/r04/src/selection_config.h

#ifndef C07_SELECTION_CONFIG_H
#define C07_SELECTION_CONFIG_H
/* c07 r04 settings supplied by CMake cache/compile definitions.
 * Hardware acceptance is recorded separately from this implementation. */
static inline void c07_selection_apply(c07_config *c){
    c->MPPT_METHOD=C07_SELECTION_METHOD;
    c->MPPT_STEP_MODE=C07_SELECTION_STEP_MODE;
    c->MPPT_PERIOD_US=C07_SELECTION_PERIOD_US;
    c->MPPT_SETTLE_US=C07_SELECTION_SETTLE_US;
    c->MPPT_WINDOW_US=C07_SELECTION_WINDOW_US;
    c->MPPT_STEP_MIN_V=C07_SELECTION_MIN_V;
    c->MPPT_STEP_MAX_V=C07_SELECTION_MAX_V;
    c->MPPT_STEP_GAIN_V=C07_SELECTION_GAIN_V;
    c->POWER_DEADBAND_W=C07_SELECTION_POWER_DB_W;
    c->MPPT_VOLTAGE_DEADBAND_V=C07_SELECTION_VOLTAGE_DB_V;
    c->MPPT_CURRENT_DEADBAND_A=C07_SELECTION_CURRENT_DB_A;
    c->IL_RISE_A_PER_S=C07_SELECTION_SLEW_A_PER_S;
}
#endif
