MahleCube/solar-circuit/(commit log)

2026-10-29 docs: add c07 BOM spreadsheet and portfolio entry
    [c07_BOM.xlsx]
2026-10-30 docs: add verified C07 KiCad schematics and three-page PDF
    Include project-local symbol libraries and opening instructions for the saved r06 schematic. Preserve the existing BOM and record artifact checksums.
    [C07_Solar.kicad_sch, LTC4364_Protection.kicad_sch, PV_Reverse_Protection.kicad_sch]
2026-10-30 Simplify portfolio to BOM, schematic sources and PDF
    Keep one concise top-level README. Remove supplementary documentation, checksums, the empty code stub and an unused symbol library.
2026-10-30 作業中のC07 PCBを追加し、未完成であることを明記
    [C07_Solar.kicad_pcb, C07_Solar.kicad_sch, LTC4364_Protection.kicad_sch, PV_Reverse_Protection.kicad_sch]
2026-10-30 Remove KiCad data opening instruction from README
    Removed instruction for opening KiCad data in README.
2026-10-30 Add clean c07 MATLAB circuit drawing
    Remove the three area frames and twelve long external annotations while preserving components, wiring, values and block descriptions. Include opening dependencies, a Windows MATLAB loader, file hashes and circuit previews.
    Saved-model comparison and package opening verified; no simulation performed.
2026-11-05 Correct r04 synchronous buck commutation and control supervision
    [board.c, board.h, board_config.h, c07_control.c, c07_control.h, commissioning.h, commutation.c, commutation.h]
2026-11-05 Align r04 startup and recovery with C07 protection paths
    Enable the declared synchronous operating profile, start the LTC4364 path during the limited output ramp, and reach its UV release voltage at low battery voltage. Preserve fault causes through PWM shutdown and retry ordinary source loss through the full input rearm sequence.
    Remove unsupported instantaneous loss and diode-mode current vetoes while retaining current regulation, measured-temperature derating, gate non-overlap and finite output shutdown. Keep the existing IncCond, voltage PID and current PI separation.
2026-11-06 Keep r04 PWM continuous across duty updates
    Latch a complete synchronous or diode-mode PWM command at each cycle boundary and retain the previous command until the next update. Remove finite DMA packet restarts from normal control.
    Use a separate PIO liveness counter and sticky fault clamps for shutdown, preserving stop causes and deliberate restart behavior. Keep the existing C07 circuit parameters, IncCond, voltage PID and current PI settings.
2026-11-06 Fix r04 low-light MPPT tracking and charging recovery
    Separate normal charge hold and input shortage from latched faults. Correct input-current limit priority, track applied PWM for DCM feedback, and use local time-compensated IncCond with bounded observation windows. Preserve continuous PWM and the inner-loop cadence.
    Add a narrow low-current response diagnostic. General current-sensor gain faults and physical fault-stress qualification remain unresolved.
    [board.c, board.h, c07_control.c, c07_control.h, startup.c, startup.h]
2026-11-06 Detect inconsistent nonzero current feedback in r04
    Compare independent PV input charge with confirmed PWM and raw inductor current during falling input voltage. Keep the existing near-zero response diagnostic separate and preserve normal tracking commands and periods.
    Original 45 scenario runs and additional ARM checks completed with fresh ABI. This does not qualify sensor faults generally or component transient tolerance; established zero-feedback stress remains unresolved.
    [startup.c, startup.h]
2026-11-06 Update C07 PCB to r26 with socketed Pico and M3 mounts
    Publish the reviewed six-layer PCB and its matching schematics, rules,
    libraries, and 3D assets. Preserve the exact r26 PCB bytes and document
    unverified manufacturing and hardware conditions.
    [Bourns_CSS4J_4026R_1L00.step, C07_Solar.kicad_pcb, C07_Solar.kicad_sch, KEMET_R76IR433050H3J_mounted.step, LTC4364_Protection.kicad_sch, PV_Reverse_Protection.kicad_sch, SCHURTER_SMD_SPT_5x20.step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]
2026-11-06 Limit sudden zero-current feedback drive while preserving normal MPPT
2026-11-07 Revise README for solar charging system project
    Updated the README to clarify the project status and details.
2026-11-07 Update README with project details
    Added additional information about the solar charging system.
2026-11-09 C07回路図の整理と図面枠を反映
    [C07_Solar.kicad_sch, LTC4364_Protection.kicad_sch, PV_Reverse_Protection.kicad_sch]
2026-11-09 Sample control feedback last within each 601 us frame
    Read and convert monitoring channels before the paired PV samples and final inductor-current sample. Skip identity calibration arithmetic to retain the control deadline at low irradiance.
    [board.c]
2026-11-11 docs: show PCB 3D render at top of README
2026-11-11 docs: tighten PCB image framing and remove caption
